Raph1821/SpiRobs/LaTeX/main.tex

\documentclass[a4paper, 11pt]{report}
\usepackage[a4paper, margin=1.5cm]{geometry}

% Police
\usepackage{lmodern}

% Interlignes et paragraphes
\usepackage{setspace} % pour l'interligne
\usepackage{parskip}  % pour gérer l'espacement entre les paragraphes

% Pour les espacements entre les titres
\usepackage{titlesec}
\titlespacing*{\subsubsection}{0pt}{0.5em}{0.3em}  % marge gauche, avant, après

% Interligne multiple de 1.15
\setstretch{1.15}

% Espace après paragraphe : 6pt
\setlength{\parskip}{6pt}
\setlength{\parindent}{0pt} % Retrait en début de paragraphe

\usepackage{titlesec}
\usepackage{etoolbox}
\usepackage{chngcntr}

% Compteur pour les chapitres personnalisés
\newcounter{chapcount}
\renewcommand{\thechapcount}{\arabic{chapcount}}

% Redéfinir \section pour l'affichage personnalisé
\titleformat{\section}
  {\centering\Large\bfseries} % Style : centré, gros, en gras
  {Chapitre \thechapcount   :}   % Numérotation personnalisée
  {0.3em}                        % Espace entre "chapitre X :" et le titre
  {}

% Incrémenter le compteur à chaque section
\preto\section{\stepcounter{chapcount}}

\usepackage[french]{babel}
\usepackage[utf8]{inputenc}
\usepackage[T1]{fontenc}

\usepackage{graphicx} % Pour les images
\graphicspath{Figures}
\usepackage{caption}
\usepackage{siunitx} % for S column in tabular
\usepackage{subcaption}
\usepackage{amsmath, amsfonts, amssymb} %Pour les maths

\usepackage{textcase}

\usepackage{afterpage}

\usepackage[symbol]{footmisc} % pour utiliser * au lieu de 1,2,3

\usepackage{float}  % pour [H]

% La numérotation

\makeatletter\@addtoreset{section}{chapter}\makeatother
\renewcommand{\thepart}{\Roman{part}}
\renewcommand{\thechapter}{\arabic{chapter}}
\renewcommand{\thesection}{\arabic{section}}
\renewcommand{\thesubsection}{\arabic{chapcount}.\alph{subsection}}
\renewcommand{\thefootnote}{\fnsymbol{footnote}}  % active les symboles pour les footnotes

\usepackage{chngcntr}
\counterwithin{figure}{section}

% Sommaire + hyperliens

\usepackage[hyphens]{url}
\usepackage[pdfauthor = {{Julien Sagnes}}, pdftitle = {{Rapport de Projet}}, pdfstartview = Fit, pdfpagelayout = SinglePage, pdfnewwindow = true, bookmarksnumbered = true, breaklinks, colorlinks, linkcolor = black, urlcolor = black, citecolor = black, linktoc = all]{hyperref}
\usepackage[
    left = \flqq{},% 
    right = \frqq{},% 
    leftsub = \flq{},% 
    rightsub = \frq{} %
]{dirtytalk} % permet de citer mieux

% Codes

\usepackage{booktabs}
\usepackage{listings}
\usepackage{xcolor}
\usepackage[section]{placeins}
\usepackage{enumitem}
\usepackage{accsupp}

\newcommand{\noncopynumber}[1]{%
    \BeginAccSupp{method=escape,ActualText={}}%
    #1%
    \EndAccSupp{}%
}

\lstdefinestyle{csvstyle}{
    basicstyle=\ttfamily\small,
    backgroundcolor=\color{gray!5},
    frame=single,
    columns=fullflexible,
    breaklines=true,
    postbreak=\mbox{\textcolor{red}{$\hookrightarrow$}\space}
}

\definecolor{codegreen}{rgb}{0,0.6,0}
\definecolor{codegray}{rgb}{0.5,0.5,0.5}
\definecolor{codepurple}{rgb}{0.58,0,0.82}
\definecolor{backcolour}{rgb}{0.95,0.95,0.92}

\lstdefinestyle{mystyle}{
    backgroundcolor=\color{backcolour},   
    commentstyle=\color{codegreen},
    keywordstyle=\color{magenta},
    numberstyle=\tiny\color{codegray},
    stringstyle=\color{codepurple},
    basicstyle=\ttfamily\footnotesize,
    breakatwhitespace=false,         
    breaklines=true,                 
    captionpos=b,                    
    keepspaces=true,                 
    numbers = left,
    numberstyle=\tiny\noncopynumber,
    numbersep=5pt,                  
    showspaces=false,                
    showstringspaces=false,
    showtabs=false,                  
    tabsize=2,
    literate=
  {á}{{\'a}}1 {é}{{\'e}}1 {í}{{\'i}}1 {ó}{{\'o}}1 {ú}{{\'u}}1
  {Á}{{\'A}}1 {É}{{\'E}}1 {Í}{{\'I}}1 {Ó}{{\'O}}1 {Ú}{{\'U}}1
  {à}{{\`a}}1 {è}{{\`e}}1 {ì}{{\`i}}1 {ò}{{\`o}}1 {ù}{{\`u}}1
  {À}{{\`A}}1 {È}{{\'E}}1 {Ì}{{\`I}}1 {Ò}{{\`O}}1 {Ù}{{\`U}}1
  {ä}{{\"a}}1 {ë}{{\"e}}1 {ï}{{\"i}}1 {ö}{{\"o}}1 {ü}{{\"u}}1
  {Ä}{{\"A}}1 {Ë}{{\"E}}1 {Ï}{{\"I}}1 {Ö}{{\"O}}1 {Ü}{{\"U}}1
  {â}{{\^a}}1 {ê}{{\^e}}1 {î}{{\^i}}1 {ô}{{\^o}}1 {û}{{\^u}}1
  {Â}{{\^A}}1 {Ê}{{\^E}}1 {Î}{{\^I}}1 {Ô}{{\^O}}1 {Û}{{\^U}}1
  {œ}{{\oe}}1 {Œ}{{\OE}}1 {æ}{{\ae}}1 {Æ}{{\AE}}1 {ß}{{\ss}}1
  {ű}{{\H{u}}}1 {Ű}{{\H{U}}}1 {ő}{{\H{o}}}1 {Ő}{{\H{O}}}1
  {ç}{{\c c}}1 {Ç}{{\c C}}1 {ø}{{\o}}1 {å}{{\r a}}1 {Å}{{\r A}}1
  {€}{{\EUR}}1 {£}{{\pounds}}1
}
\lstset{style=mystyle}

\begin{document}

\definecolor{darkWhite}{rgb}{0.94,0.94,0.94}

% Page de garde

\begin{titlepage}
    \setcounter{page}{1}
    \thispagestyle{plain}
    \newcommand{\HRule}{\rule{\linewidth}{0.5mm}}
    \begin{center}
        \begin{minipage}{1\linewidth}
            \begin{flushleft}
                \hspace{6.5cm}
                
            \end{flushleft}
        \end{minipage}

        \vspace{1.5cm}
        
        \textsc{\Large{}Master Sciences de l'ingénieur - Sorbonne Université} \\[0.5cm]
        \textsc{\large{}Année 2024 - 2025} \\[0.5cm]

        \HRule \\[0.6cm]
        {\huge\bfseries{}Rapport de projet de M1, parcours SAR :} \\
        \LARGE{Conception et réalisation d'une pince à trois doigts souples} \\[0.25cm]
        \HRule \\[1.5cm]

        \Large\textit{Auteurs :}\\
        \begin{center}
            Julien \textsc{Sagnes}\\
            Minh \textsc{Nhut Nguyen}
        \end{center}

        \hfill

        \Large\textit{Encadrant :}\\
        \begin{center}
            Faiz \textsc{Ben Amar}
        \end{center}
        \vspace{1cm}
        {\large\today} \\[2cm]
    \end{center}

    \vfill
\end{titlepage}

\setcounter{page}{2}

\selectlanguage{french}
% Résumé sur une page séparée avant la table des matières
\clearpage
\section*{Résumé}
\addcontentsline{toc}{section}{Résumé}

Ce rapport présente la conception, la modélisation et la simulation d’une pince robotique à trois doigts souples, destinée à la préhension d’objets légers comme des fruits et des légumes, et avec une capacité de charge maximale de 5 kg. S’appuyant sur les principes du robot SpiRob et des structures souples bio-inspirées, le système utilise des doigts imprimés en 3D en TPU selon une géométrie en spirale logarithmique, actionnés par un mécanisme vis-écrou couplé à des câbles. En outre, l’élasticité intrinsèque des doigts leur permet de revenir spontanément à leur position initiale lorsque les câbles sont relâchés.

Le document s’ouvre sur un état de l’art consacré aux préhenseurs souples et aux dispositifs d’actionnement par câbles, en soulignant les avantages de la compliance passive ainsi que les contraintes à relever en termes de charge et de tension des câbles. Un approfondissement est également mené sur la simulation d’élasticité par éléments finis, afin d’évaluer le comportement mécanique des structures souples. La conception de la pince est ensuite décrite de manière détaillée, depuis la définition mathématique des spirales jusqu’à la modélisation complète des pièces sous SolidWorks. Cette modélisation comprend la base, les doigts et les éléments de transmission (glissière, vis, écrou, support moteur), tout en prenant en compte les principales contraintes de conception, notamment les jeux, les frottements et l’hyperstatisme.

Enfin, une simulation par éléments finis permet d’évaluer les contraintes subies lors de la fermeture des doigts en TPU. Les résultats montrent que la pince peut saisir des objets de masse modérée sans dépasser la limite d’élasticité du matériau. Toutefois, au-delà d’une tension de 15 Newton, une plastification ou une fatigue du TPU peut survenir. L’ajout d’un élément de rappel mécanique, tel qu’un élastique, est donc recommandé afin de garantir le retour des doigts à leur position initiale.

\clearpage
\tableofcontents
\clearpage

\setcounter{chapcount}{0} % Démarre le compteur à zéro juste avant l'introduction
\section{Introduction}

    Dans l'industrie, la robotique collaborative, ou cobotique, est omniprésente. Elle vise à soulager l’être humain en prenant en charge les tâches pénibles, notamment à l’aide de préhenseurs conçus spécifiquement pour manipuler des charges de taille et de poids variable, souvent associées à des tâches répétitives.

    Ce projet consiste à concevoir et dimensionner une pince robotique à trois doigts souples, conçue pour s'ouvrir et se refermer en s'adaptant à l'objet saisi. L'objectif est de réussir à attraper des fruits et légumes relativement légers, comme un poivron. Idéalement, nous devrons pouvoir soulever des objets allant jusqu'à 5 kilogrammes. Nous utiliserons SolidWorks pour modéliser la pince, et étudierons son élasticité par éléments finis via le module \textit{SolidWorks Simulation}.

    \subsection{Motivations et principes fondamentaux}

        \begin{figure}[h]
            \centering
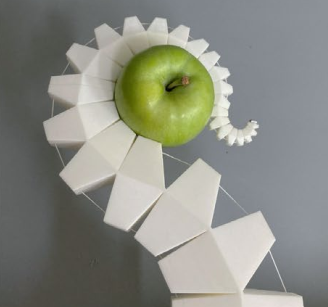
[picture p9: LaTeX/Figures/pieuvre.png]
            
            \caption{Inspiration du SpiRob pour les 3 doigts de notre pince \cite{wang_spirobs_2025}}
            \label{fig:pieuvre}
        \end{figure}
    
        Dans notre cas, et comme souvent en robotique, les objets à manipuler ont une forme ou une position mal connue, et contrairement à une main humaine, les pinces robotiques manquent de retour tactile fiable. Pour cette raison, nous n'allons pas utiliser de retour haptique, mais plutôt des préhenseurs souples. Pour concevoir nos doigts, nous nous inspirons de la flexibilité des tentacules de pieuvre et du robot SpiRob (voir figure \ref{fig:pieuvre}). Cela permettra à la pince de s'adapter naturellement à la forme de divers fruits et légumes sans nécessiter de capteurs ni de système de contrôle complexe, mais simplement grâce à la compliance mécanique. En effet, la compliance désigne la capacité d’un robot à adapter la rigidité de ses mouvements en fonction des forces extérieures qu'il subit. Autrement dit, il ajuste naturellement sa posture pour bien épouser l’objet qu’il manipule. Dans ce projet, nous nous concentrons sur la compliance passive, où la structure mécanique du robot est suffisamment flexible pour se déformer sous l'effet d'une contrainte externe. Cette approche permet une préhension polyvalente et adaptable. \cite{noauthor_gestion_2016}

        \begin{figure}[h]
            \centering
            \begin{subfigure}[t]{0.7\textwidth}
                \centering
                
                \caption{Spiral logarithmique du préhenseur \cite{wang_spirobs_2025}}
                \label{fig:spiral_logarithm}
                \end{subfigure}
            \hfill
            \begin{subfigure}[t]{0.6\textwidth}
                \centering
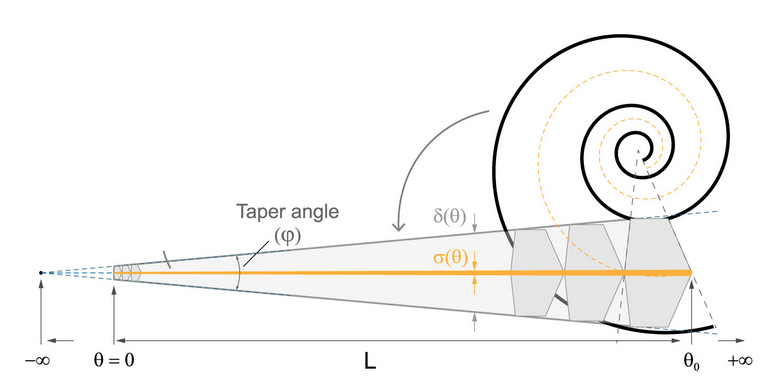
[picture p10: LaTeX/Figures/draw_solidworks.png]
                
                \caption{Construction du doigt en "dépliant" la spirale logarthimique \cite{wang_spirobs_2025}}
                \label{fig:draw_solidworks}
            \end{subfigure}
            \caption{Conception du doigt}
            \label{fig:doigt}
        \end{figure}

        Les SpiRobs dont nous nous inspirons utilisent des câbles pour provoquer les mouvements d'enroulement (curling) et de déroulement (uncurling). Une extrémité du câble est fixée à l'unité distale par un nœud de pêcheur, tandis que l'autre est reliée à un moteur (voir figure~\ref{fig:spiral_logarithm}). La contraction des câbles entraîne l'enroulement en spirale logarithmique, alors que leur relâchement, combiné à l'élasticité intrinsèque du robot, restitue la forme initiale. En effet, les SpiRobs sont entièrement fabriqués en TPU (Thermoplastic Polyurethane). Ce matériau souple, que nous utiliserons également, offre une bonne compliance mécanique et une rigidité suffisante pour transmettre efficacement la tension des câbles. La couche centrale qui relie entre elles les phalanges agit comme un ressort passif, permettant le déroulement du robot sans nécessiter d’articulations ni de moteurs multiples~\cite{wang_spirobs_2025}.

    \subsection{Comportement et structure de la pince à concevoir}
    
        La pince pourra adopter deux configurations : ouverte ou fermée. Elle est constituée de trois doigts en TPU souple, d’une hauteur de 10 cm chacun, encastrés rigidement à une base. Les doigts seront positionnés symétriquement autour du centre de la base, séparés par un angle de 120°. Ils devront être dimensionnés de manière à éviter toute plastification du TPU et garantir le comportement élastique attendu. Une étude de l’élasticité devra en conséquence être effectuée. Par ailleurs, trois câbles, passant du côté fléchisseur de chaque doigt, permettront leur actionnement grâce à un moteur chargé de régler leur tension. Dans ce type de mécanisme, la tension appliquée aux câbles constitue en effet une préoccupation majeure, car si elle est insuffisante, elle peut provoquer un relâchement des câbles et compromettre le contrôle efficace du mouvement. Du reste, pour limiter la friction des câbles, nous pouvons utiliser des câbles UHMWPE pour leur faible coefficient de frottement et leur résistance à l'usure. \cite{wang_spirobs_2025}
        
\clearpage

\section{État de l'art}

    Dans un premier temps, nous proposons un état de l'art sur les préhenseurs souples et leurs actionneurs afin d'avoir une vue globale sur leurs intérêts et les solutions existantes.

    \subsection{Préhenseurs souples}

            \begin{figure}[htbp]
                \centering
                \begin{subfigure}[t]{0.5\textwidth}
                    \centering
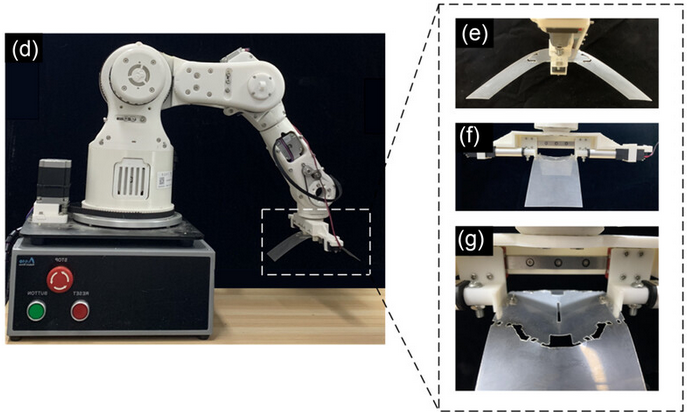
[picture p11: LaTeX/Figures/robot.png]
                    
                    \caption{Robot portant la pince souple \cite{liu_origami_2023}}
                    \label{fig:pince_PVC}
                \end{subfigure}
                \hfill
                \begin{subfigure}[t]{0.5\textwidth}
                    \centering
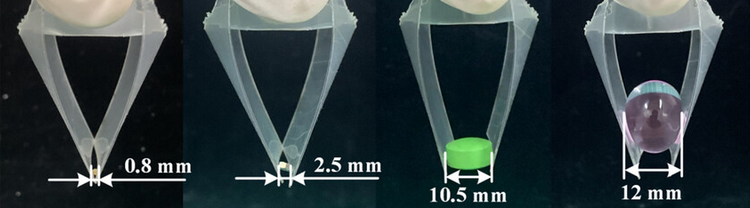
[picture p12: LaTeX/Figures/adaptability.png]
                    
                    \caption{Adaptation de la pince souple \cite{liu_origami_2023}}
                    \label{fig:prehension_adapt}
                \end{subfigure}
                \caption{Pince en PVC souple}
                \label{fig:resume_origami}
            \end{figure}

            Cette étude a été menée afin de concevoir des préhenseurs souples en origami, permettant une adaptabilité de préhension pour de nombreux objets. La pince, qui n'est qu'une simple feuille de PVC (voir figure \ref{fig:pince_PVC}), est commandée à l'aide d'un moteur linéaire. Grâce à sa structure flexible, elle peut saisir efficacement des objets de taille diverse pour le même actionnement (voir figure \ref{fig:prehension_adapt}). Cependant, sa capacité de préhension demeure limitée pour des charges dépassant 113.88 g, la force de préhension de la pince et les frottements n’étant pas suffisants pour maintenir ou saisir ces objets.

            Ces travaux mettent en évidence la grande adaptabilité des préhenseurs souples, tout en soulignant leur capacité de charge limitée. Notre pince vise à dépasser cette contrainte en améliorant la préhension grâce à la présence de trois doigts.
                
    \subsection{Actionnement par câbles}

        \subsubsection{Mécanisme \textit{level wind}}

            \begin{figure}[htbp]
                \centering

                \begin{subfigure}[t]{0.3\textwidth}
                    \centering
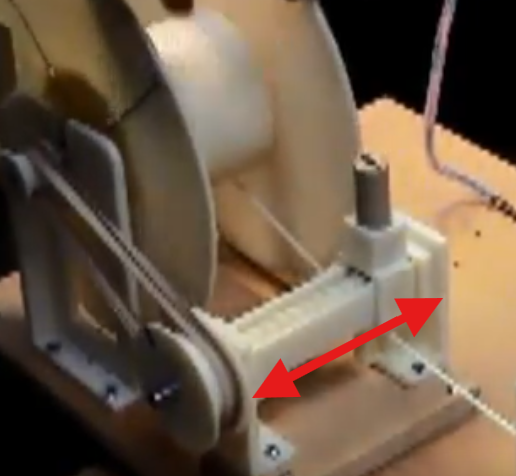
[picture p13: LaTeX/Figures/video.png]
                    
                    \caption{Illustration du mécanisme d'enroulement \cite{hugh_lyman_level_2014}}
                    \label{fig:video}
                \end{subfigure}
                \hspace{0.1\textwidth}
                \begin{subfigure}[t]{0.5\textwidth}
                    \centering
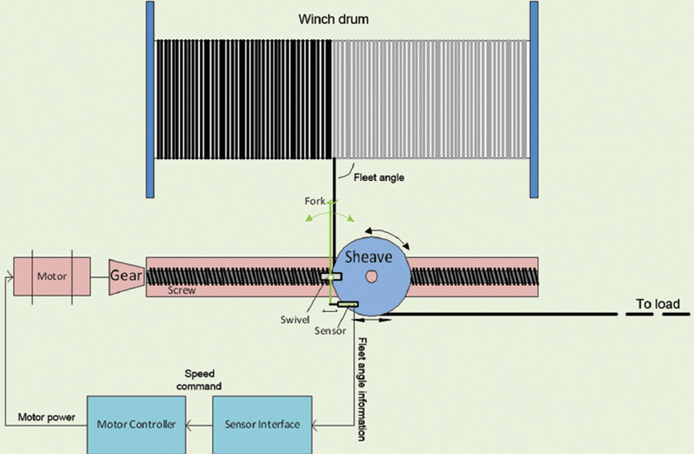
[picture p14: LaTeX/Figures/level_wind.png]
                    
                    \caption{Principe de fonctionnement du système type \textit{level wind} \cite{mortensen_precision_2014}}
                    \label{fig:level_wind}
                \end{subfigure}
                \caption{Représentation du mécanisme \textit{level wind}}
            \end{figure}

            Le mécanisme \textit{level wind} est un dispositif utilisé notamment sur les moulinets de pêche, qui guide le fil de pêche latéralement pendant l’enroulement pour éviter les enchevêtrements et maintenir une tension constante. La vidéo \cite{hugh_lyman_level_2014} illustre ce mécanisme (voir figure \ref{fig:video}).

            Sur la figure \ref{fig:level_wind}, nous proposons une illustration du système. Une poulie se déplace le long d'une vis grâce à un moteur, et enroule alors le fil tout le long du tambour. L'approche la plus répandue pour la conception d'un tel système consiste en un rapport d'engrenage fixe entre la rotation du tambour du treuil et la poulie de l'enrouleur de niveau. Un rapport fixe signifie que pour chaque tour complet du tambour, la poulie se déplace d'une distance constante. En somme, cela permet à la poulie de se déplacer horizontalement à une vitesse proportionnelle à celle de rotation du tambour.
            
            Cette solution est parfaitement envisageable pour notre pince, puisque nous resterons dans des plages de distance et de vitesse relativement faibles, limitant ainsi toute accumulation d’erreur dans la position de la poulie par rapport au tambour.

        \subsubsection{Vis à bille}

            \begin{figure}[h]
                \centering
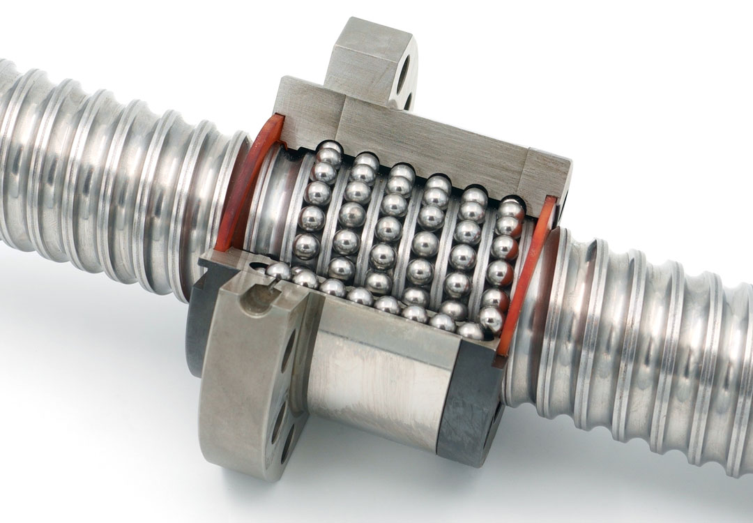
[picture p15: LaTeX/Figures/vis_à_bille.jpg]
                
                \caption{Illustration en coupe d'une vis à billes \cite{noauthor_gradel-baudin_nodate}}
                \label{fig:vis_a_billes}
            \end{figure}

            Enfin, nous nous intéressons à l’actionnement par vis à billes, un système comparable au mécanisme vis-écrou classique, et qui permettrait de tendre ou de détendre les câbles. En effet, les vis à billes sont parmi les composants les plus couramment employés pour convertir la rotation d’un moteur en mouvement linéaire. Elles présentent l’avantage de réduire considérablement les frottements, grâce au contact entre la vis et l’écrou qui s’effectue uniquement par l’intermédiaire de billes (voir figure \ref{fig:vis_a_billes}). \cite{verl_double_2014}

    \subsection{Simulation par éléments finis}
    
        En outre, nous étudions le cas d'une simulation d'un doigt robotique qui présente de nombreuses similitudes au nôtre.

        \begin{figure}[htbp]
            \centering
            \begin{subfigure}[b]{0.4\textwidth}
                \centering
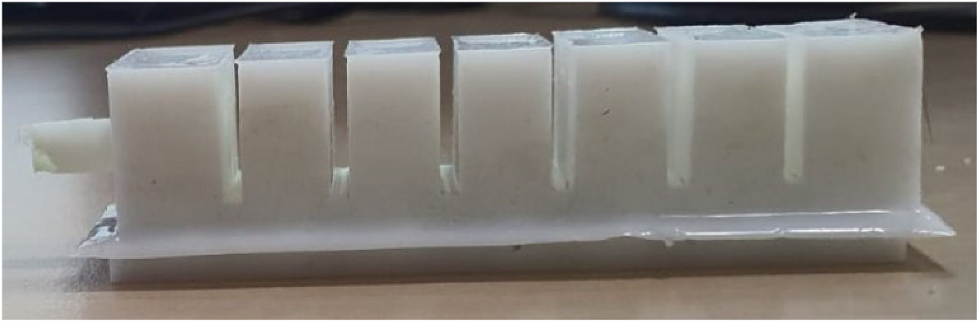
[picture p16: LaTeX/Figures/doigt_souple.jpg]
                
                \caption{Doigt souple inspiré d'un humain \cite{bhat_numerical_2025}}
                \label{fig:doigt_souple}
            \end{subfigure}
            \hspace{0.1\textwidth}
            \begin{subfigure}[b]{0.3\textwidth}
                \centering
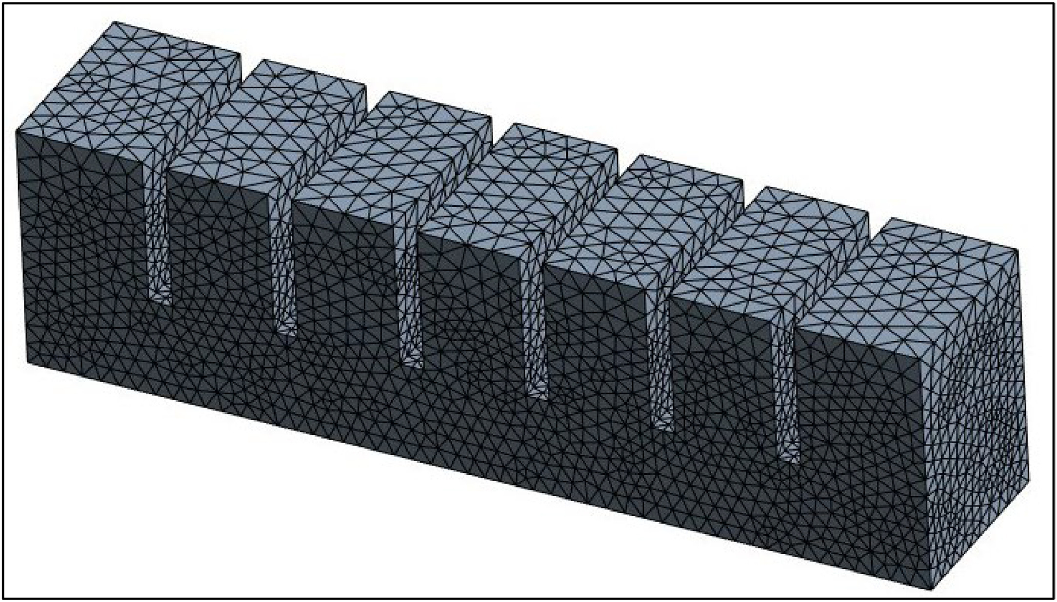
[picture p17: LaTeX/Figures/doigt_finit_elements.jpg]
                
                \caption{Représentation du maillage du doigt \cite{bhat_numerical_2025}}
                \label{fig:doigt_finit_elements}
            \end{subfigure}
            \caption{Illustrations du doigt souple et de son maillage}
            \label{fig:doigts_cote_a_cote}
        \end{figure}

        Dans \cite{bhat_numerical_2025}, les auteurs développent un actuateur souple pneumatique bio-inspiré, conçu pour la préhension douce et les applications thérapeutiques. Ce dispositif imite la flexion d’un doigt humain par l'action de la pression sur des chambres internes segmentées (voir figure \ref{fig:doigt_souple}).

        L’effecteur est réalisé en silicone liquide (LSR), un matériau hyperélastique beaucoup plus souple que notre TPU, avec un module d’Young environ dix fois inférieur. Le comportement élastique est modélisé par la loi de Yeoh d'ordre 2, et est supposé isotrope, homogène et incompressible. Le modèle est défini par la formulation faible du problème établie par l'équation d'équilibre : $div(\sigma) + \rho f = 0$, avec \( \sigma \) le tenseur des contraintes, \( \rho \) la masse volumique, et \( f \) les forces volumiques.

        L’analyse est menée via un modèle éléments finis utilisant des tétraèdres quadratiques (éléments d'ordre 2), avec un maillage raffiné (\( 63\,772 \) éléments, taille 3 mm).

        \begin{figure}[H]
            \centering
            \begin{subfigure}[b]{0.4\textwidth}
                \centering
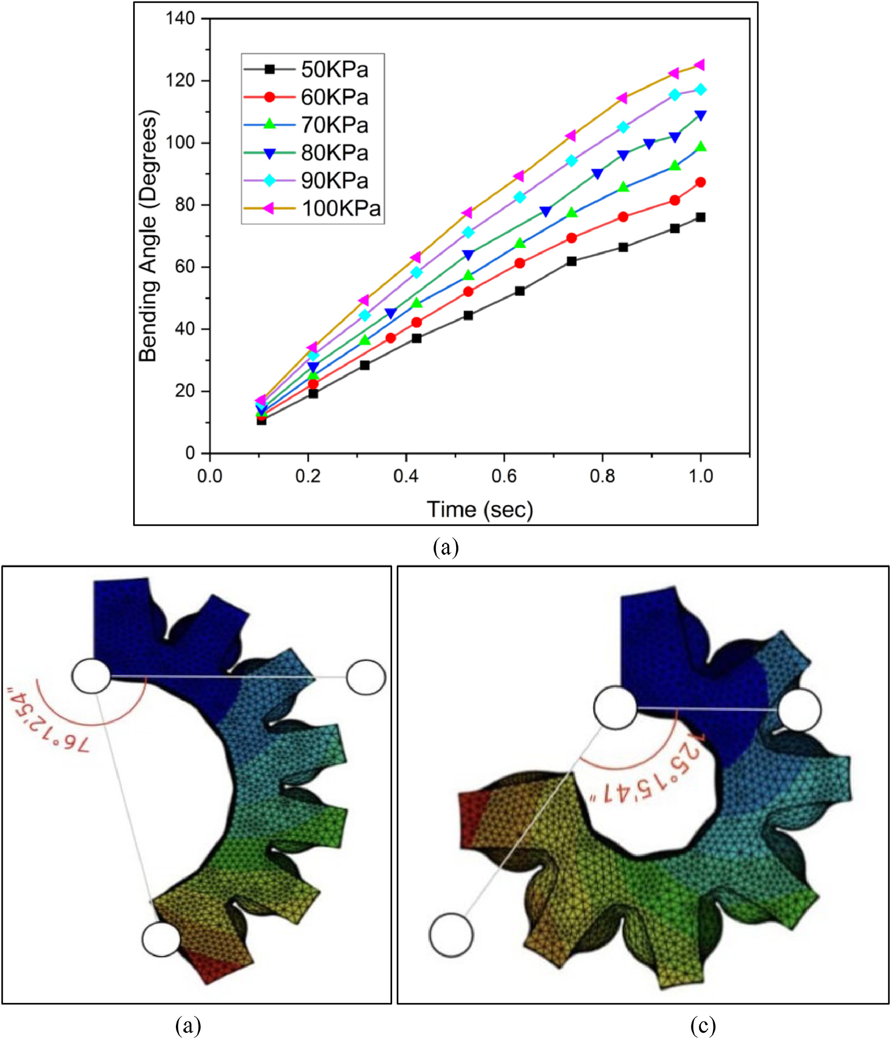
[picture p18: LaTeX/Figures/angle_pression.jpg]
                
                \caption{Angle parcouru suivant la pression exercée (en haut), et effecteur pour une pression de 50 kPa et 100 kPa.}
                \label{fig:angle_pression}
            \end{subfigure}
            \hspace{0.1\textwidth}
            \begin{subfigure}[b]{0.4\textwidth}
                \centering
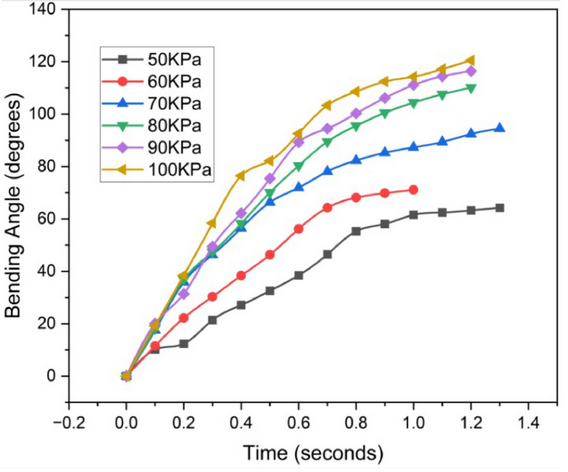
[picture p19: LaTeX/Figures/angle_pression_experiments.png]
                
                \caption{Angle parcouru suivant la pression exercée lors de l'expérience.}
                \label{fig:angle_pression_experiments}
            \end{subfigure}
            \caption{Comparaison entre les résultats numériques et expérimentaux \cite{bhat_numerical_2025}.}
            \label{fig:angle_pression_comparaison}
        \end{figure}

        La simulation indique que l’actionneur produit une force de préhension comprise entre 2 et 2,71 N pour des pressions allant de 50 à 100 kPa (voir figure \ref{fig:angle_pression}). En revanche, les résultats expérimentaux montrent une relation moins linéaire (voir figure \ref{fig:angle_pression_experiments}) et une force maximale plus élevée, atteignant 5 N à 100 kPa, alors que la simulation ne prévoit que 2,71 N. Cette différence s’explique par un débit d’air prolongé lors des tests expérimentaux, ce qui permet à l’actionneur de se gonfler davantage et donc de générer une force plus importante.

        Ces travaux mettent en évidence que les résultats obtenus par simulation par éléments finis peuvent s’écarter significativement des observations expérimentales. Bien que notre approche par câbles soit différente, cet article nous a été utile pour explorer un modèle de déformation et réaliser une simulation à l’aide d’un logiciel de CAO.

\clearpage
        
\section{Conception de la pince}
        
    \subsection{Considérations mathématiques}

        Dans \cite{wang_spirobs_2025}, les auteurs expliquent comment dessiner le SpiRob. Comme dit précédemment, nous nous inspirons de sa forme pour concevoir nos doigts.

        \subsubsection{Spirale centrale}
            
            Sur la figure \ref{fig:spiral_logarithm}, la spirale centrale (notée $r_c(\theta)$, en orange) qui définit notre robot vérifie la relation :
            \begin{equation}
            r_c(\theta) = \frac{r(\theta) + r(\theta + 2\pi)}{2}, \quad \forall \theta
            \label{eq:spirale_centrale}
            \end{equation}
            
            Cela signifie qu’on prend le rayon de la spirale qui enveloppe le robot (notée $r(\theta)$, en noir) au point $\theta$ ($r(\theta)$), et au point $\theta + 2\pi$ ($r(\theta + 2\pi)$), et on calcule leur moyenne. Cela donne un point « central » pour chaque angle $\theta$, et en les reliant, on forme la spirale centrale. \cite{wang_spirobs_2025}

        \subsubsection{Coefficients de la spirale centrale}
        
            La spirale logarithmique centrale en coordonnées polaires est de la forme :

            \begin{equation}
                r_c(\theta) = a_c e^{b_c \theta}, \quad \text{avec} \quad a_c > 0
                \label{eq:spirale_log}
            \end{equation}

            Afin que la première phalange ne soit pas trop petite, la spirale centrale sera bornée par $\theta \in [\pi, \theta_0 + \pi]$, avec $\theta_0$ le nombre de tours de la spirale. De plus, $a_c$ est un paramètre d’échelle (elle détermine la taille globale de la spirale), tandis que $b_c$ est un coefficient qui détermine à quel point la spirale s’enroule (plus $b_c$ est grand, plus la spirale est "serrée"). Contrairement à \cite{wang_spirobs_2025}, nous n'aurons pas besoin qu'un doigt s'enroule plusieurs fois autour de l'objet pour le saisir étant donné que nous concevons ici une pince à trois doigts. Ainsi, la spirale centrale parcourra au plus 1 seul tour ($\theta_0 = 2\pi$), et $a_c$ et $b_c$ seront choisis de telle sorte qu'on obtienne la longueur désirée $L$ du doigt, soit $10$ cm.

            Pour déterminer la valeur de \( a_c \) en fonction de $b_c$ afin de satisfaire la condition sur $L$, nous procédons comme suit :

            La longueur totale \( L \) de la spirale centrale est donnée par l'intégrale de l'arc de \( \pi \) à \( 3\pi \) :
            \[
            L = \int_\pi^{\theta_0 +\pi} \sqrt{r_c^2 + \left(\frac{dr_c}{d\theta}\right)^2} \, d\theta, \quad \text{pour} \ \theta_0 = 2\pi \left( = 1 \text{ tour complet} \right)
            \]
            
            Substituons dans la racine carrée : $\sqrt{r_c^2 + \left( \frac{dr_c}{d\theta} \right)^2} = \sqrt{a_c^2 e^{2b_c \theta} (1 + b_c^2)} = a_c e^{b_c \theta} \sqrt{1 + b_c^2}$
            
            La longueur totale devient : $L = \int_\pi^{3\pi} a_c e^{b_c \theta} \sqrt{1 + b_c^2} \, d\theta = a_c \sqrt{1 + b_c^2} \int_\pi^{3\pi} e^{b_c \theta} \, d\theta$
            
            Calculons l'intégrale : $\int_\pi^{3\pi} e^{b_c \theta} \, d\theta = \left[ \frac{1}{b_c} e^{b_c \theta} \right]_\pi^{3\pi} = \frac{1}{b_c} \left( e^{b_c \cdot 3\pi} - e^{b_c \cdot \pi} \right)$
            
            Ainsi, la longueur totale de la spirale centrale est : $L = a_c \sqrt{1 + b_c^2} \cdot \frac{1}{b_c} \left( e^{b_c \cdot 3\pi} - e^{b_c \cdot \pi} \right)$
            
            En isolant \( a_c \) :

            \begin{equation}
            a_c(b_c) = \frac{L b_c}{\sqrt{1 + b_c^2} \left( e^{b_c \cdot 3\pi} - e^{b_c \cdot \pi} \right)}, \qquad \text{avec L connue}
            \label{eq:a}
            \end{equation}

        \subsubsection{Spirale déroulée}

            Etant donné l'équation (\ref{eq:a}), il ne reste qu'à déterminer la valeur optimale de $b_c$ pour définir l'équation de notre doigt. Nous la calculerons en fonction d'un angle de conicité $\phi$ désiré (\textit{taper angle} sur la figure \ref{fig:draw_solidworks}) :

            \begin{equation}
            \phi(b_c) = 2\arctan \left(
                \frac{\frac{1}{2}\delta(\theta)}{L(-\infty, \theta)}
                \right) = 2 \arctan\left(\frac{b_c(e^{2\pi b_c}-1)}{\sqrt{b_c^2+1} \left(e^{2\pi b_c}+1\right)}\right)
            \label{eq:angle_de_conicite}
            \end{equation}

            Avec :

            \begin{itemize}
                \item l'épaisseur du robot à l'angle $\theta$ : $\delta(\theta) = a_ce^{b_c(\theta + 2\pi)} - a_ce^{b_c\theta}$
                \item la longueur du robot entre $[-\infty,\theta]$ : $L(-\infty, \theta) = \int_{-\infty}^{\theta} \sqrt{r_c^2 + \left(\frac{dr_c}{d\theta}\right)^2} \, d\theta$.
            \end{itemize}

            Le fait que $\phi$ soit indépendant de $\theta$ signifie que la forme est effilée \cite{wang_spirobs_2025}.

        \subsubsection{Nombre de phalanges}
            
            Enfin, nous devrons choisir l'espacement $\Delta\theta$ entre les phalanges de la figure \ref{fig:spiral_logarithm} pour définir entièrement la forme et la taille du doigt. On peut alors en déduire le nombre de phalanges N puisque $\theta_0 = 2\pi$ :
        
            \begin{equation}
                N = \frac{\text{Angle total}}{\Delta \theta}
                = \frac{\theta_0}{\Delta \theta}
                = \frac{2\pi}{\Delta \theta}
                \label{eq:nb_segment}
            \end{equation}

    \subsection{Cahier des charges retenu} 

            \begin{itemize}
                \item Angle de conicité (ou \textit{taper angle}) : $\phi \ = \ 15^o \ = \ \frac{\pi}{12} \ rad$ 
                \item Angle entre 2 phalanges adjacentes : $\Delta \theta \ = \ 30^o \ = \ \frac{\pi}{6} \ rad$
                \item Couche élastique qui relient les phalanges : 10 $\%$ de la largeur du doigt
            \end{itemize}

            \subsubsection{Discussion sur le cahier des charges à respecter}

            L'angle de conicité de la spirale joue un rôle clé dans les performances de préhension du doigt, notamment en termes d’espace de travail, de précision de saisie et de capacité de charge. 
            D’après les résultats rapportés dans \cite{wang_spirobs_2025}, un faible angle de conicité permet d’augmenter significativement l’espace de travail, en élargissant la zone accessible par les doigts lors du déploiement. À l’inverse, un angle de conicité plus élevé améliore la performance de saisie : il permet de saisir des objets de plus petite taille (diamètre minimal réduit) tout en augmentant la capacité de charge maximale du robot.
            Par exemple, un SpiRob avec un angle de conicité de $15^\circ$ peut saisir des objets dont le diamètre varie de 5{,}6\,mm à 115\,mm, et supporter une charge allant jusqu’à 10\,kg, soit environ 260 fois son propre poids (poids du robot : 38{,}4\,g). \cite{wang_spirobs_2025} Notre but étant de manipuler des fruits et légumes de diamètres allant jusqu'à 10 cm, nous avons choisi d’adopter un angle de conicité de $\phi = 15^\circ$.

            Concernant la discrétisation angulaire $\Delta \theta$ (espacement des phalanges), une valeur trop élevée limite la capacité du robot à s’enrouler en une spirale logarithmique fluide, ainsi nous choisissons un $\Delta \theta$ de 30° pour garantir une déformation satisfaisante. Il convient également d’éviter une couche élastique trop épaisse (au centre du doigt robotique), car cela augmenterait la force nécessaire pour enrouler le doigt, rendant l'actionnement par câbles plus exigeant pour le moteur qui utiliserait alors davantage d'énergie. Nous adoptons les recommandations de \cite{wang_spirobs_2025}, en optant pour une épaisseur de couche élastique de 10\,\%, assurant un bon compromis entre élasticité et force d’enroulement.

        \subsubsection{Détermination des paramètres pour répondre au cahier des charges}

            Pour satisfaire les exigences du cahier des charges ci-dessus, nous cherchons les valeurs des paramètres $N$, $a_c$ et $b_c$ qui y répondent : 

            Comme montré dans l’équation (\ref{eq:nb_segment}), le nombre de phalanges dépend de l’angle total $\theta_0$ et l'espacement $\Delta \theta$, on peut donc déduire le nombre de phalanges comme suit :

            \[
                N = \frac{2\pi}{\Delta \theta}
                = \frac{2\pi}{\frac{\pi}{6}}
                = 12 
            \]
            
            Il y aura donc 12 phalanges.

            Ensuite, nous devons déterminer $b_c$ de telle sorte que $\phi = \frac{\pi}{12}$.
            
            Nous le calculons grâce à l'équation (\ref{eq:angle_de_conicite}) en appliquant la méthode \texttt{fsolve} de \texttt{Python}:

            \begin{lstlisting}[language=Python,caption={Résolution numérique du paramètre $b$},label={lst:resolu_b},xleftmargin=0pt]

            # Résolution de l'équation pour b
            def equation(b):
                if b == 0:
                    return -taper_angle_rad  # éviter division par 0
                numerator = b * (np.exp(2 * np.pi * b) - 1)
                denominator = np.sqrt(b**2 + 1) * (np.exp(2 * np.pi * b) + 1)
                angle = 2 * np.arctan(numerator / denominator)
                return angle - taper_angle_rad

            # Valeur initiale proche (tester avec 0.05, 0.1, etc.)
            b_solution = fsolve(equation, x0=0.01 , xtol = 1e-6)[0]
            if b_solution <= 0:
                raise ValueError("La solution pour b doit être positive.")
            b=b_solution
            \end{lstlisting}

            La fonction \texttt{equation} renvoie la différence :
            \[
            \texttt{equation}(b) = \phi(b) - \texttt{taper\_angle\_rad}, \qquad \text{pour} \texttt{ taper\_angle\_rad} = \frac{\pi}{12}
            \]

            Ainsi, la résolution de \( \texttt{equation}(b_c) = 0 \) correspond à trouver la racine de cette fonction, c'est-à-dire la valeur de \( b \) pour laquelle \(\phi(b)\) est égale à \(\texttt{taper\_angle\_rad}\).

            \textbf{Signification de \texttt{x0} et \texttt{xtol} dans \texttt{fsolve}} :
            \begin{itemize}
                \item \(\mathbf{x0}\) : C'est la \textit{valeur initiale} ou \textit{point de départ} donné à l'algorithme numérique pour commencer la recherche de la racine. Comme la résolution numérique dépend du point de départ, choisir un \( x_0 \) proche de la racine attendue facilite la convergence et évite d'obtenir des solutions erronées.

                \item \(\mathbf{xtol}\) : C'est la \textit{tolérance sur la solution} que l'on fixe pour arrêter la recherche de la racine. Plus précisément, lorsque la variation de \( x \) (la valeur approchée de la racine) entre deux itérations est inférieure à \(\texttt{xtol}\), l'algorithme considère que la solution est suffisamment précise et s'arrête.
            \end{itemize}

            \textbf{Nous avons donc reçu la valeur de $b_c\ =\ 0.2230302381847426$, et avons déduit $a_c\ =\ 3.530268404263818$ avec l'équation (\ref{eq:a})}.

        Ainsi, afin que notre doigt réponde au cahier des charges, il faut que la spirale centrale d'équation (\ref{eq:spirale_log}) soit définie par :

        \[
        r_c = a_c e^{b_c\theta}, \qquad \text{avec } b_c = 0.2230, \text{ } a_c = 3.5303
        \]

        Nous cherchons maintenant l'équation de la spirale qui enveloppe le doigt, soit $r(\theta) = f(r_c(\theta))$. Pour cela, on peut
        déduire la formule inverse de (\ref{eq:spirale_centrale}) en posant $r(\theta) = ae^{b\theta}$ :

        $$r_c(\theta) = \frac{r(\theta) + r(\theta + 2\pi)}{2}, \quad \forall \theta$$

        $$r_c(\theta) = \frac{ae^{b\theta} + ae^{b(\theta + 2\pi)}}{2}
        = \frac{ae^{b\theta}}{2}(1 + e^{2\pi b})
        = \frac{r(\theta)}{2}(1 + e^{2\pi b})$$

        \begin{equation}
            \implies r(\theta) = \frac{2 \cdot r_c(\theta)}{1 + e^{2\pi b}}
            \label{eq:spirale_centrale_inverse}
        \end{equation}

        Nous avons l'équation des deux spirales ; nous pouvons passer au dessin du doigt.

    \subsection{Dessin sur SolidWorks}

        \subsubsection{Dessin du doigt}
            
            Nous allons expliquer comment dessiner le doigt à l'aide des outils de SolidWorks. La méthode consiste à dessiner le doigt dans sa forme enroulée, puis à enregistrer chaque phalange individuellement. Ainsi, nous nous assurons qu'il s'enroulera correctement.

            \begin{figure}[H]
                \centering
                \begin{subfigure}[t]{0.3\textwidth}
                    \centering
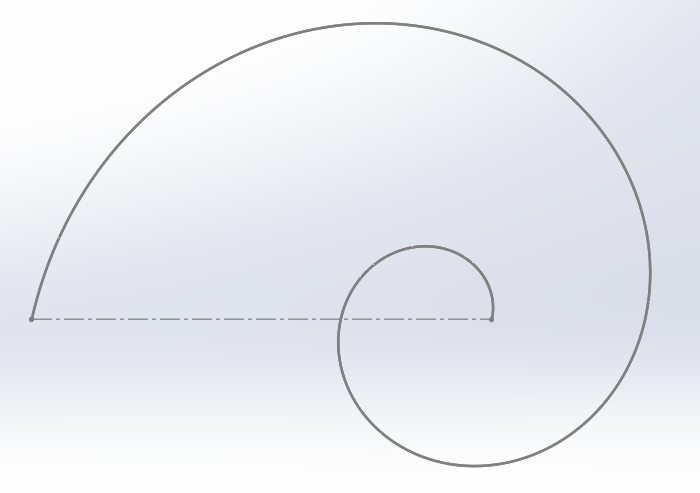
[picture p20: LaTeX/Figures/esquisse_spirale_1.png]
                    
                    \caption{Esquisse de la spirale centrale, d'équation \ensuremath{r_c = a_ce^{b_c \theta}} avec \ensuremath{\theta \in [0,3\pi]}}
                \end{subfigure}
                \hspace{0.1\textwidth}
                \begin{subfigure}[t]{0.3\textwidth}
                    \centering
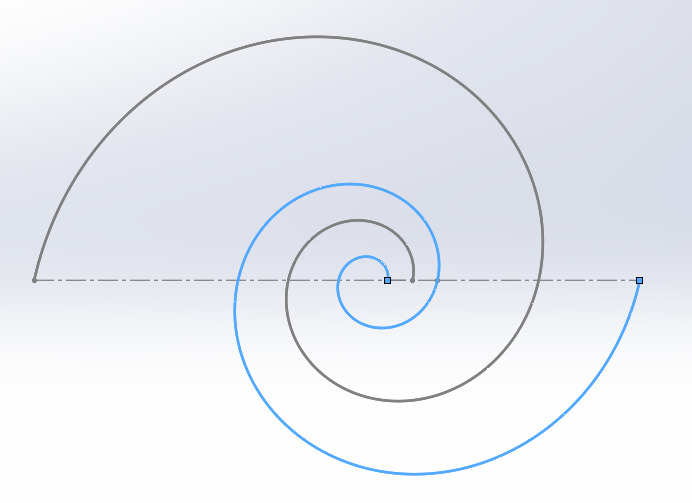
[picture p21: LaTeX/Figures/esquisse_spirale_2.png]
                    
                    \caption{Esquisse de la spirale qui enveloppe le doigt (en bleue), d'équation \ensuremath{r = \frac{2 \cdot r_c(\theta)}{1 + e^{2\pi b}}} avec \ensuremath{\theta \in [0,4\pi]}}
                \end{subfigure}
                \caption{Dessin des spirales élémentaires du doigt}
                \label{fig:esquisse_spirale}
            \end{figure}

            La figure \ref{fig:esquisse_spirale} présente les esquisses des deux spirales. Elles ont été tracées à l’aide d’une méthode paramétrique. Ces courbes permettent de valider nos calculs, puisque la spirale centrale reste bien centrée pour tout $\theta$.

            \begin{figure}[H]
                \centering
                \begin{subfigure}[t]{0.4\textwidth}
                    \centering
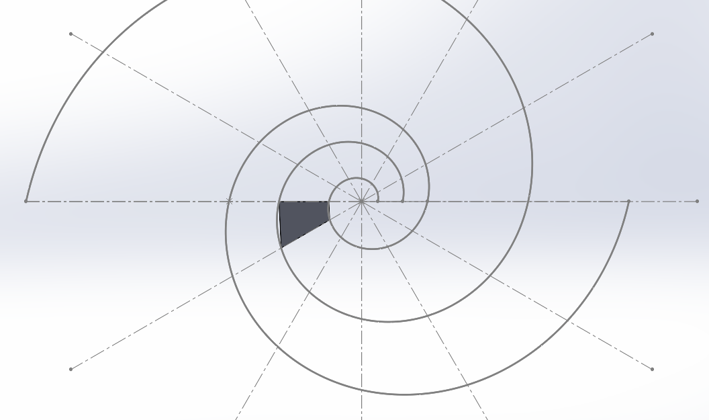
[picture p22: LaTeX/Figures/esquisse_moitié_trapèze_1.png]
                    
                    \caption{Esquisse de l'étoile pour discrétiser la spirale, et extrusion de la moitié de la première phalange à l'aide des lignes construites}
                \end{subfigure}
                \hspace{0.1\textwidth}
                \begin{subfigure}[t]{0.4\textwidth}
                    \centering
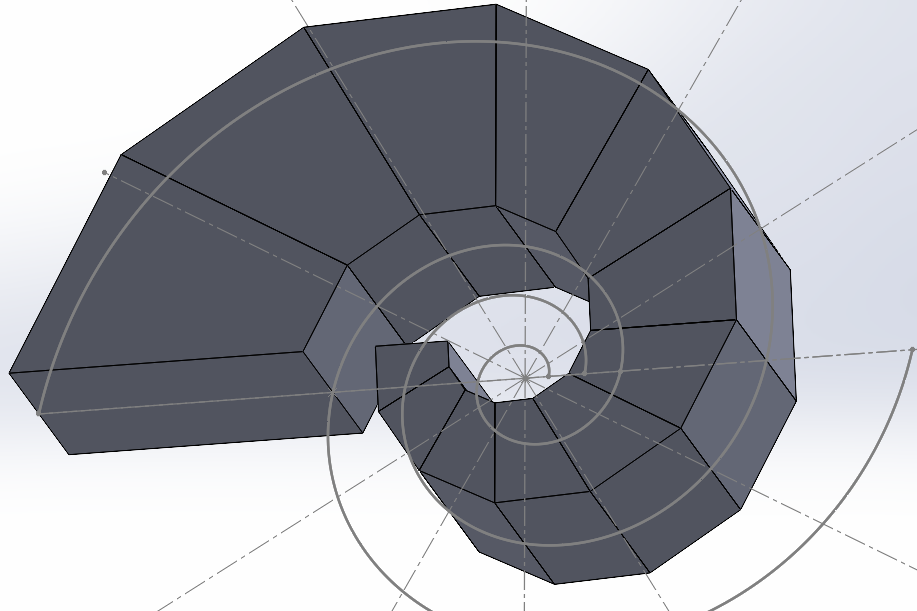
[picture p23: LaTeX/Figures/esquisse_moitié_trapèze_entier.png]
                    
                    \caption{Extrusion de toutes les moitiés des phalanges à l'aide des lignes construites}
                \end{subfigure}
                \caption{Dessin de l'étoile et des phalanges}
                \label{fig:esquisse_etoile}
            \end{figure}

            Comme illustré sur la figure \ref{fig:esquisse_etoile}, nous dessinons l'étoile dont le centre est l'origine du repère polaire utilisée pour tracer les spirales. Comme en $\theta = 0$, on a $r_c(0) = a_c e^0 = a_c$, alors l'origine de l'étoile se trouve à une distance $a_c$ du point de départ de la spirale centrale. Ensuite, nous dessinons chacune des moitiés de phalanges en prenant soin de ne pas fusionner les extrusions.

            \begin{figure}[H]
                \centering
                \begin{subfigure}[t]{0.4\textwidth}
                    \centering
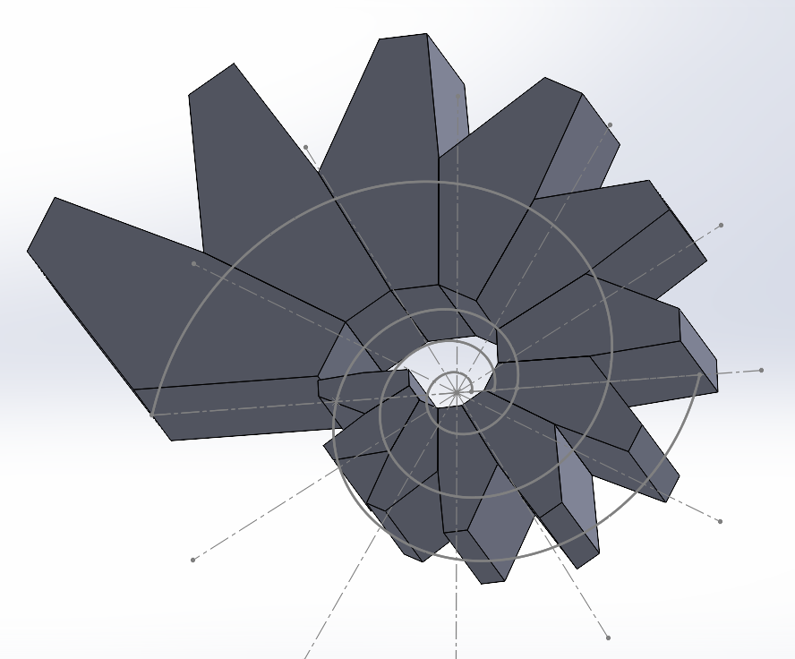
[picture p24: LaTeX/Figures/esquisse_trapèze_symetrie.png]
                    
                    \caption{Symétrie de toutes les phalanges}
                    \label{fig:symetrie_phalanges}
                \end{subfigure}
                \hspace{0.1\textwidth}
                \begin{subfigure}[t]{0.4\textwidth}
                    \centering
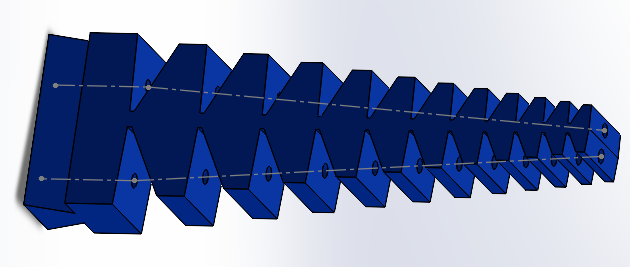
[picture p25: LaTeX/Figures/doigt.png]
                    
                    \caption{Doigt assemblé et perçage des trous sur les côtés pour faire passer le câble}
                    \label{fig:doigt_assemble}
                \end{subfigure}
                \caption{Dessin et assemblage du doigt}
                \label{fig:spirale_enroule}
            \end{figure}

            Enfin, nous rendons symétriques les moitiés de phalanges et les sauvegardons dans des fichiers de pièces distincts (voir figure \ref{fig:symetrie_phalanges}). Cela permet ensuite de les assembler de manière à obtenir un doigt déroulé. De plus, nous intégrons une couche élastique représentant 10\% de la largeur du doigt pour connecter les phalanges entre elles. Bien que chaque doigt soit actionné par un unique câble côté fléchisseur, nous prévoyons des trous de part et d’autre pour garantir la symétrie de la pièce (voir figure \ref{fig:doigt_assemble}).
            
            \subsubsection{Dessin de la base}

            \begin{figure}[H]
                \centering
                \begin{subfigure}[t]{0.5\textwidth}
                    \centering
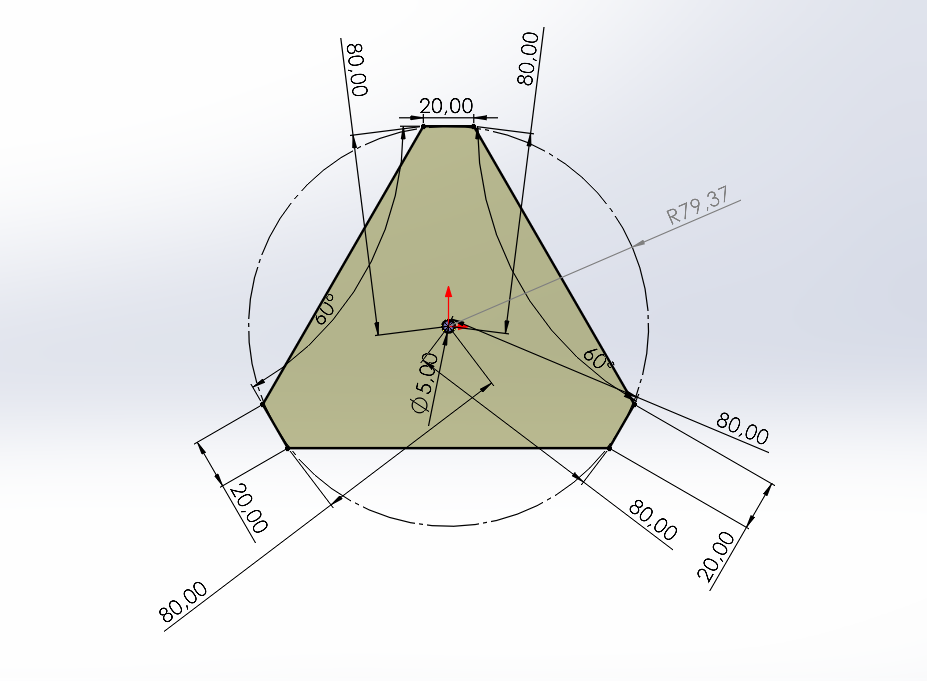
[picture p26: LaTeX/Figures/base_circonscrit.png]
                    
                    \caption{Esquisse de la base de rayon 80 mm}
                \end{subfigure}
                \hfill
                \begin{subfigure}[t]{0.4\textwidth}
                    \centering
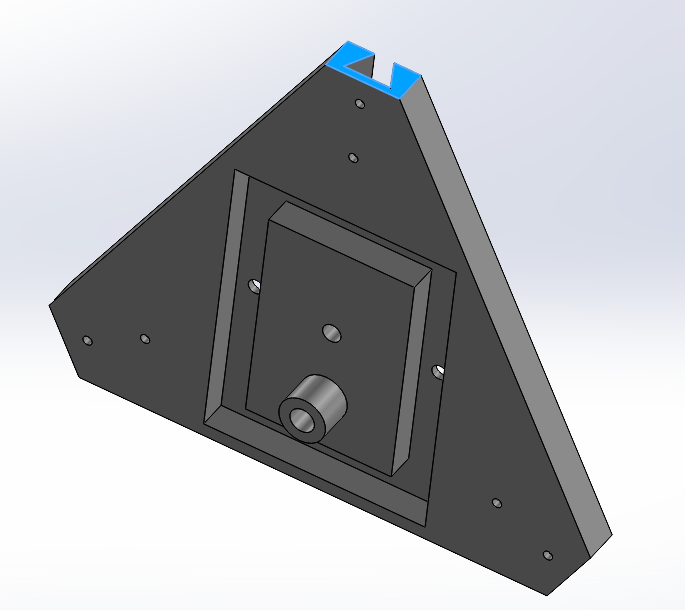
[picture p27: LaTeX/Figures/base_hareng.png]
                    
                    \caption{Illustration de la queue de hareng pour accueillir le doigt, ainsi que de la cavité pour loger le support moteur}
                \end{subfigure}
                \caption{Conception de la base}
                \label{fig:base}
            \end{figure}

            Nous concevons une base de forme triangulaire, dont le cercle circonscrit présente un rayon d’environ 80 mm, afin de pouvoir manipuler des fruits de taille conséquente. Le doigt est encastré à la base grâce à un système d’accroche en queue de hareng, avec un jeu de 0,3 mm prévu pour permettre l’assemblage (par la suite, nous adopterons toujours ce jeu pour chaque pièce). Ce même jeu est appliqué à la cavité destinée à accueillir le support moteur qui sera accroché à la base (voir figure \ref{fig:base}).
            
            \begin{figure}[H]
                \centering
                \begin{subfigure}[t]{0.3\textwidth}
                    \centering
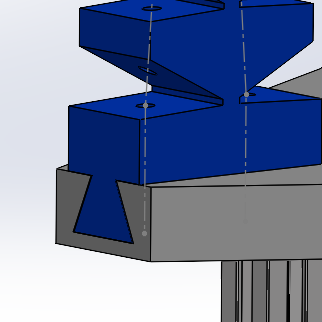
[picture p28: LaTeX/Figures/encastrement_doigt_base.png]
                    
                    \caption{Encastrement du doigt dans la base avec un jeu de 0.3 mm}
                \end{subfigure}
                \hspace{0.1\textwidth}
                \begin{subfigure}[t]{0.2\textwidth}
                    \centering
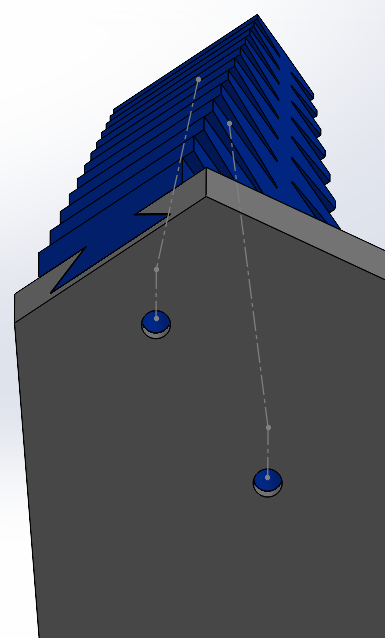
[picture p29: LaTeX/Figures/trou_base_cable.png]
                    
                    \caption{Trous dans la base pour faire passer les câbles dans les doigts}
                \end{subfigure}
                \caption{Conception de la base}
                \label{fig:base_doigt}
            \end{figure}
            
            En outre, nous n'oublions pas de creuser des trous dans la base afin de pouvoir faire passer les câbles dans les doigts (voir figure \ref{fig:base_doigt}).

        \subsubsection{Dessin du support du moteur}

            \begin{figure}[H]
                \centering
                \begin{subfigure}[t]{0.35\textwidth}
                    \centering
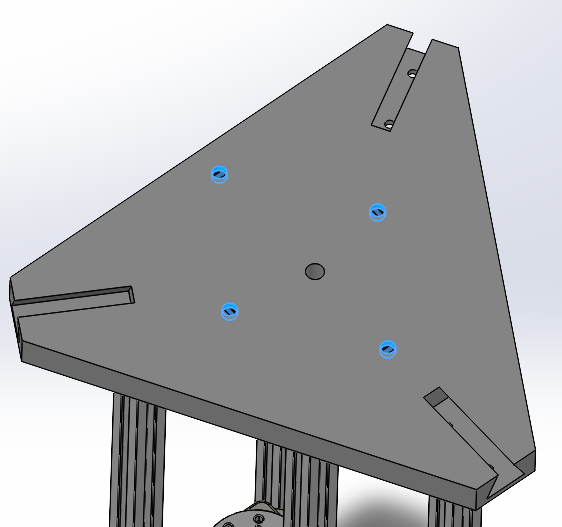
[picture p30: LaTeX/Figures/support_fixation.png]
                    
                    \caption{4 trous de diamètre 4,3 mm percés dans la base pour fixer les 4 barres (en bleu)}
                    \label{fig:fixation_base_support}
                \end{subfigure}
                \hspace{0.1\textwidth}
                \begin{subfigure}[t]{0.2\textwidth}
                    \centering
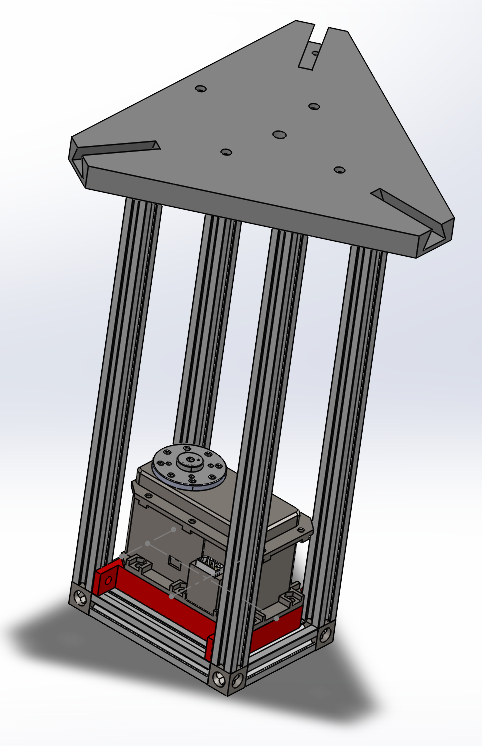
[picture p31: LaTeX/Figures/support_idee.png]
                    
                    \caption{Support moteur en MAKERBEAM, avec la pièce pour y fixer le moteur (en rouge)}
                    \label{fig:support}
                \end{subfigure}
                \caption{Conception du support}
            \end{figure}

            Le support moteur est conçu à l’aide de la bibliothèque MAKERBEAM (voir figure \ref{fig:support}). Il est assemblé à partir de barres de 40 mm, 60 mm et 200 mm, ainsi que de cubes de jonction. La fixation du support à la base est assurée par des vis à tête marteau et des boulons. Cela nécessite la réalisation de quatre perçages de 4,3 mm de diamètre dans la base, centrés sur chaque barre (voir figure \ref{fig:fixation_base_support}).

            Le servomoteur MX-106 de chez Dynamixel a été retenu pour ce montage, car il permet un contrôle précis en position et en vitesse grâce au PID intégré et offre le couple le plus élevé parmi les moteurs que nous avions à disposition (10 Nm).

            Une pièce supplémentaire est conçue pour maintenir le moteur. Elle présente des perçages en bordure permettant d'y accrocher le moteur à l'aide de vis. Les trous situés sur les extensions latérales servent à fixer la pièce sur les barres MAKERBEAM (voir figure \ref{fig:support}).

        \subsubsection{Dessin du système vis-écrou}

            \begin{figure}[H]
                \centering
                \begin{subfigure}[t]{0.5\textwidth}
                    \centering
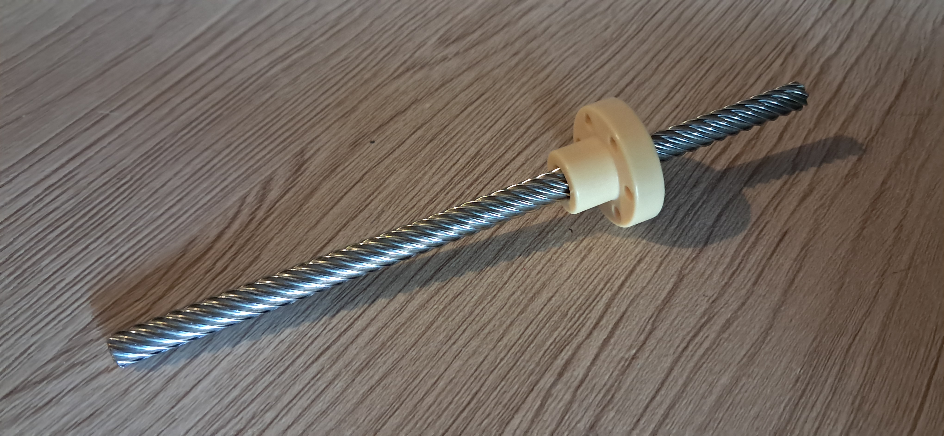
[picture p32: LaTeX/Figures/vis_sans_fin.jpg]
                    
                    \caption{Notre vis mère de la marque Igus en acier trempé, permettant un très faible frottement}
                \end{subfigure}
                \hspace{0.1\textwidth}
                \begin{subfigure}[t]{0.2\textwidth}
                    \centering
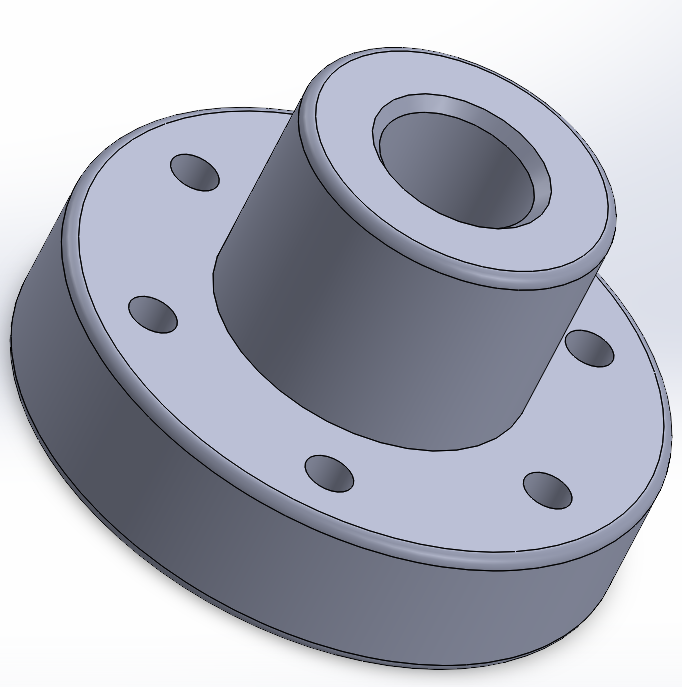
[picture p33: LaTeX/Figures/ecrou_trou.png]
                    
                    \caption{Modèle de l'écrou dessiné sur SolidWorks pour permettre l'assemblage CAO}
                \end{subfigure}
                \caption{Illustrations de la vis mère et de l'écrou}
                \label{fig:vis_sans_fin}
            \end{figure}

            Après discussion avec notre encadrant, nous avons décidé de ne pas utiliser de tambour pour l'actionnement par câbles. Bien que le tambour soit une solution efficace, l'actionnement des câbles préalablement prétendus par un système vis-écrou s’avère plus simple à mettre en œuvre et se révèle moins encombrant. À la place d'une vis à billes, nous optons pour une vis mère Igus en acier trempé afin de réduire les frottements, accompagnée d'un écrou (voir figure \ref{fig:vis_sans_fin}). Selon les recommandations du fabricant \cite{noauthor_bague_nodate}, l’écrou doit impérativement être protégé contre les efforts de torsion et les déplacements axiaux excessifs. Nous veillerons donc à intégrer des dispositifs de guidage alignés et parallèles afin d’assurer la stabilité et la durabilité du mécanisme.

            \begin{figure}[H]
                \centering
                \begin{subfigure}[t]{0.25\textwidth}
                    \centering
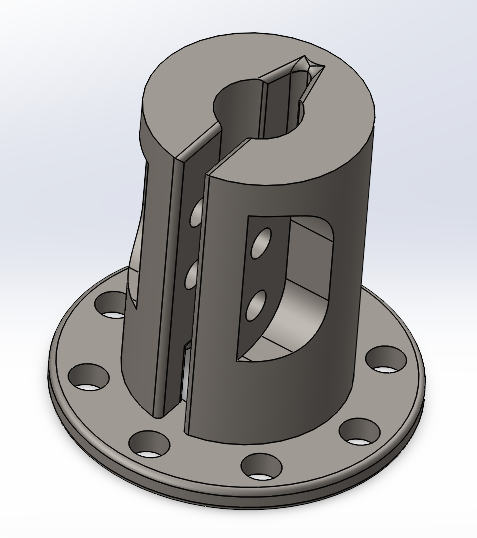
[picture p34: LaTeX/Figures/piece_manquante.png]
                    
                    \caption{Dispositif de serrage entre la vis et le moteur, pour transmettre le couple}
                    \label{fig:piece_manquante}
                \end{subfigure}
                \hspace{0.1\textwidth}
                \begin{subfigure}[t]{0.30\textwidth}
                    \centering
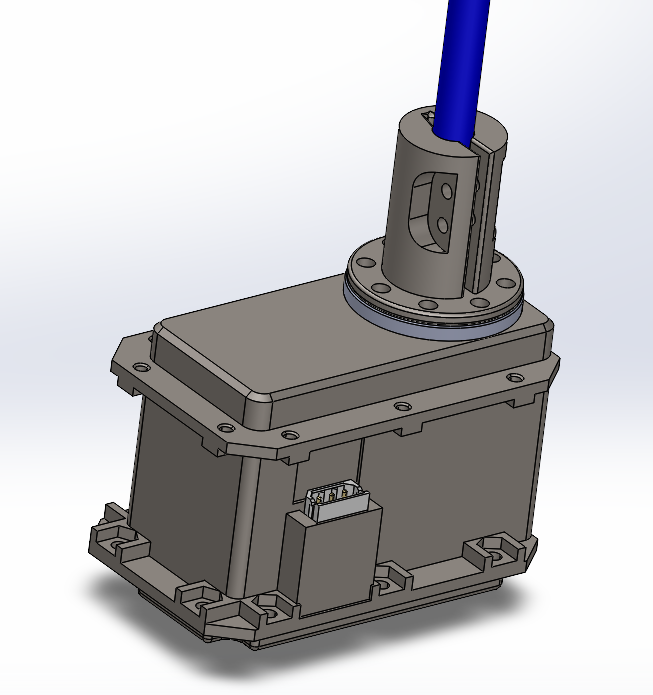
[picture p35: LaTeX/Figures/attache.png]
                    
                    \caption{Accouplement entre la vis mère (en bleue) et le moteur par le biais du dispositif de serrage}
                    \label{vis_serree}
                \end{subfigure}
                \caption{Accouplement de transimission de couple}
            \end{figure}

            Comme illustré à la figure \ref{fig:piece_manquante}, nous concevons une pièce spécifique destinée à transmettre le couple moteur à la vis mère. Inspirée d’une bague de serrage, cette pièce de transmission intègre huit perçages permettant de la fixer solidement au moteur à l’aide de vis de 2 mm de diamètre. Par ailleurs, deux vis-écrou assurent le serrage de la vis mère dans l’alésage prévu à cet effet, garantissant ainsi une bonne adhérence et une transmission efficace du mouvement (voir figure \ref{vis_serree}).

            \begin{figure}[H]
                \centering
                \begin{subfigure}[t]{0.45\textwidth}
                    \centering
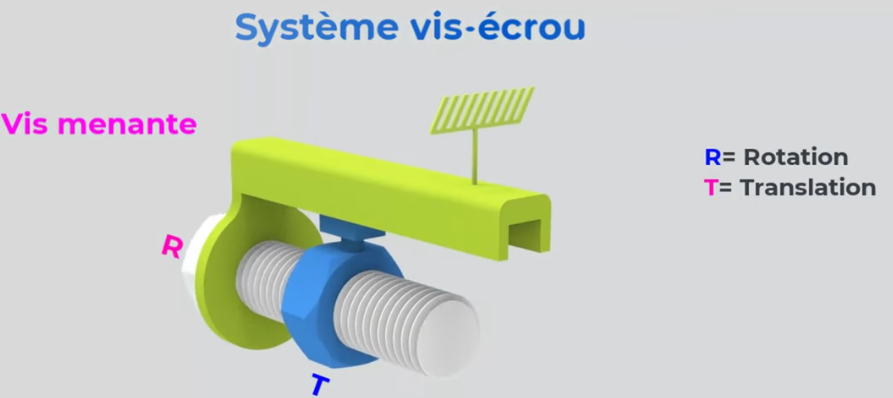
[picture p36: LaTeX/Figures/système vis écrou.png]
                    
                    \caption{Inspiration pour notre système vis écrou \cite{w3d_tech_systeme_2023}}
                    \label{fig:inspiration}
                \end{subfigure}
                \hspace{0.1\textwidth}
                \begin{subfigure}[t]{0.4\textwidth}
                    \centering
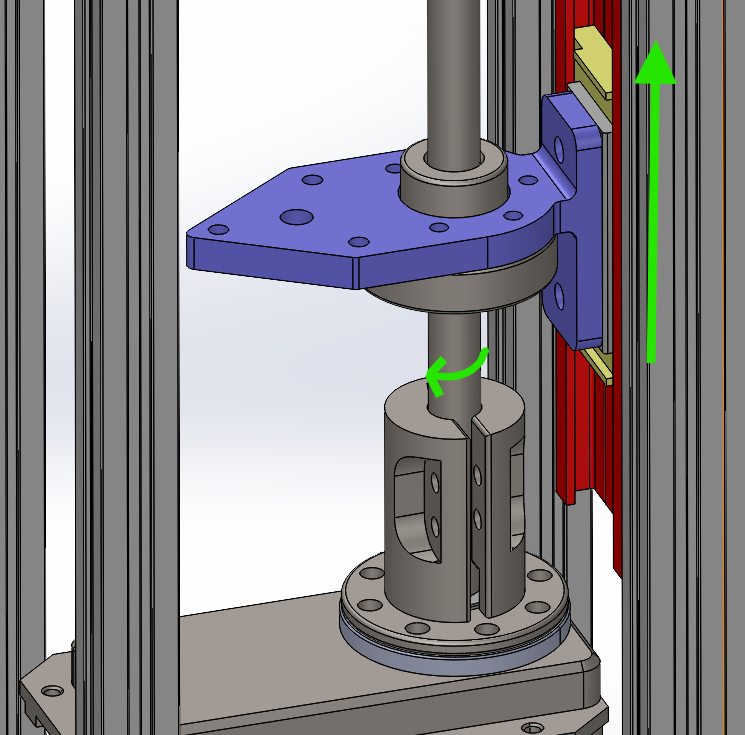
[picture p37: LaTeX/Figures/vis_ecrou_assemble.png]
                    
                    \caption{Notre système vis-écrou avec la glissière accrochée au support}
                    \label{fig:glissiere_support}
                \end{subfigure}
                \caption{Conception du système vis-écrou}
                \label{fig:attache_glissiere}
            \end{figure}

            Nous devons également associer le système vis-écrou à une glissière pour assurer le guidage linéaire. Nous avons retenu à cet effet une glissière Igus, modèle NK-01-27, accompagnée de son chariot. Il convient donc de la fixer sur le support réalisé avec la bibliothèque MAKERBEAM. Pour cela, nous utilisons une pièce de cette bibliothèque qui permet de solidariser au support la nouvelle barre destinée à recevoir la glissière.

            Du reste, la conception du système vis-écrou s’inspire de la vidéo \cite{w3d_tech_systeme_2023}. Sur la figure \ref{fig:inspiration}, le rail supérieur en vert maintient l’écrou en rotation bloquée, ce qui lui permet de translater lorsqu’un moteur fait tourner la vis. Par ailleurs, ce système empêche l’emmêlement des câbles : l’écrou reste fixe en rotation et ne fait que translater.

            Nous devons ainsi concevoir une pièce intermédiaire destinée à relier la glissière à l’écrou (en bleu sur la figure \ref{fig:glissiere_support}). Pour garantir l’hyperstatisme de l’assemblage, un minimum de trois vis est nécessaire pour fixer cette pièce à l'écrou. Nous en profitons également pour intégrer à l’extrémité de la pièce un triangle comportant trois trous aux sommets, destinés à y nouer les câbles des doigts. Étant positionné au centre du support, ce triangle présente une distance égale aux trois doigts, assurant ainsi une course identique pour chacun des câbles. En d’autres termes, l’actionnement des doigts sera ainsi uniforme.

        \subsubsection{Pince assemblée}

            \begin{figure}[H]
                \centering
                \begin{subfigure}[t]{0.40\textwidth}
                    \centering
                    
                    \caption{Pince assemblée sur SolidWorks}
                    \label{fig:pince_CAO}
                \end{subfigure}
                \hspace{0.1\textwidth}
                \begin{subfigure}[t]{0.35\textwidth}
                    \centering
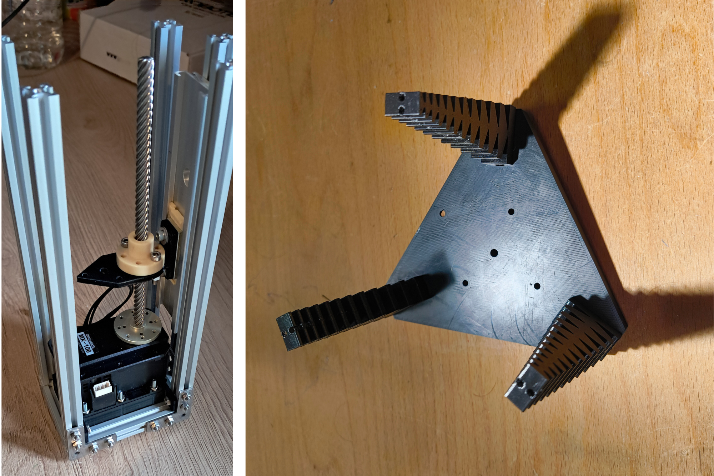
[picture p38: LaTeX/Figures/reel.png]
                    
                    \caption{Pièces imprimées et montage du support en MAKERBEAM}
                    \label{fig:reel}
                \end{subfigure}
                \caption{Conception du système vis-écrou}
                \label{fig:pince_assemble}
            \end{figure}

            Sur la figure \ref{fig:pince_assemble}, nous proposons une illustration de l'assemblage CAO finale de notre pince, ainsi que des photos de la réalisation. La sphère verte sur la base permet de simuler une pomme de diamètre 8 cm.

\clearpage

\section{Résultats}

    \subsection{Simulation et étude de l'élasticité via \textit{SolidWorks Simulation}}

        \subsubsection{Création des matériaux dans SolidWorks}

            \textit{TPU}

                Pour simuler les contraintes et les déplacements dans SolidWorks, il est nécessaire d'intégrer les propriétés mécaniques du TPU que nous utiliserons pour les doigts. Dans \cite{rodriguez-parada_influence_2021}, les auteurs utilisent un TPU de module d'Young 26 MPa. Étant donné notre objectif d’éviter tout comportement plastique, nous privilégions un matériau présentant un module d’Young relativement faible. Ainsi, pour obtenir une première estimation des efforts maximaux, et par conséquent du couple moteur à ne pas dépasser, nous retenons une valeur volontairement majorée de 30 MPa pour le module d’Young dans la simulation (sachant que plus il est élevé, moins le matériau est souple étant donnée la loi de Hooke $\sigma = E \epsilon$). Enfin, comme critère de vérification, nous adoptons comme limite d’élasticité celle du eTPU-95a utilisé dans \cite{wang_spirobs_2025}, soit $\sigma_{limite} = 8,6$ MPa.
            
            \textit{PLA}

                Pour les autres pièces imprimées, nous privilégions l'utilisation de PLA, dont le module d'Young est d’environ 3 GPa, afin de garantir une rigidité suffisante face aux efforts transmis par les câbles. Cela permet de s’assurer que les déformations se produisent comme prévu au niveau des doigts, et non sur la base.

        \subsubsection{Méthode}

            De même que dans le cadre de l'étude \cite{bhat_numerical_2025}, nous restons dans l'hypothèse des matériaux homogènes, isotropes et incompressibles. Nous décidons également de négliger la gravité. En effet, d'après SolidWorks, notre doigt mesure $25$ grammes. Son poids est donc d'environ $0,25$ N, or les forces des câbles seront de l'ordre de l'unité, voire de la dizaine de Newton puisque l'on souhaite attraper des objets allant jusqu'à 5 kilogrammes ($50$ Newton). Ainsi, la gravité représente moins de $1$ \% des efforts subis par le doigt.

            \begin{figure}[H]
                \centering
                \begin{subfigure}[t]{0.3\textwidth}
                    \centering
                    
                    \caption{Condition limite d'encastrement sur la base}
                    \label{fig:encastrement}
                \end{subfigure}
                \hspace{0.1\textwidth}
                \begin{subfigure}[t]{0.3\textwidth}
                    \centering
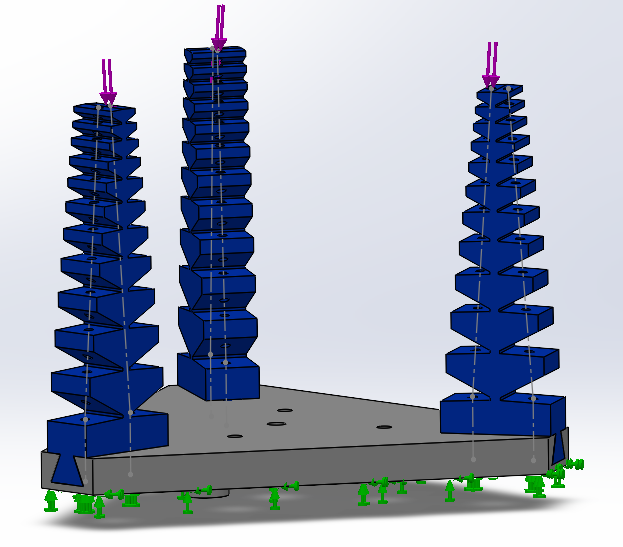
[picture p39: LaTeX/Figures/force_3_doigts.png]
                    
                    \caption{Simulation des forces (en violet) engendrées par les câbles sur l'extrémité des doigts}
                    \label{fig:force}
                \end{subfigure}
                \caption{Mise en place d'un problème bien posé}
            \end{figure}

            Dans le logiciel, nous commencons par créer une nouvelle étude statique. L’onglet \textit{Déplacements imposés} permet de définir les conditions limites, notamment en fixant la géométrie, c'est-à-dire ajouter un encastrement sur la base (voir figure \ref{fig:encastrement}, cela revient à négliger les déformations de la base dont le module d'Young est 100 fois plus élevé que celui des doigts). Ensuite, l’onglet \textit{Chargements externes} sert à appliquer les forces. Pour simuler la tension des câbles subie par les doigts, nous ajoutons une force à l'extrémité des pièces dans la direction du trou qui accueille le câble (voir figure \ref{fig:force}).

            \begin{figure}[H]
                \centering
                \begin{subfigure}[t]{0.3\textwidth}
                    \centering
                    
                    \caption{Création du maillage}
                    \label{fig:maillage}
                \end{subfigure}
                \hspace{0.1\textwidth}
                \begin{subfigure}[t]{0.4\textwidth}
                    \centering
                    
                    \caption{Simulation des contraintes}
                    \label{fig:simulation}
                \end{subfigure}
                \caption{Exécution de la simulation par éléments finis}
                \label{fig:simulation4}
            \end{figure}

        \subsubsection{Résultats}
            
            Nous générons un maillage de \(2,7 \times 10^{5}\) éléments basé sur la courbure, avant d'exécuter la simulation avec des forces de 4~N appliquées sur chacun des 3 doigts pour modéliser la prise uniforme d’un objet d’environ \(0,4 \times 3 = 1,2\) kg. Il est important de bien différencier la tension des câbles, qui correspond ici à la force de 4 N exercée sur les doigts, et la force de préhension réelle. En effet, la force de frottement qui retient l’objet est forcément plus faible que la tension exercée par les câbles : la charge effective pourrait ainsi être divisée par deux, soit environ 0,6 kg. Le logiciel va ensuite calculer les déformations et les déplacements, ainsi que les contraintes équivalentes de Von-Mises. On peut remarquer dans ce cas que la limite d'élasticité n'est pas dépassée (voir figure~\ref{fig:simulation4}) :

            \[
            2{,}346\ \text{MPa} < 8{,}6\ \text{MPa} \quad \Rightarrow \quad \sigma_{\text{max}} < \sigma_{\text{limite}}
            \]

            Ainsi, la pince peut facilement soulever des fruits ou légumes de quelques centaines de grammes sans déformation permanente, comme une pomme ou un poivron pesant en moyenne entre 150 et 200 grammes.

            \begin{figure}[h]
            \centering
            \begin{subfigure}[b]{0.5\textwidth}
                \centering
                
                \caption{Analyse des contraintes maximales pour différentes valeurs de forces}
                \label{fig:etude_de_conception_a}
            \end{subfigure}
            \hfill
            \begin{subfigure}[b]{0.4\textwidth}
                \centering
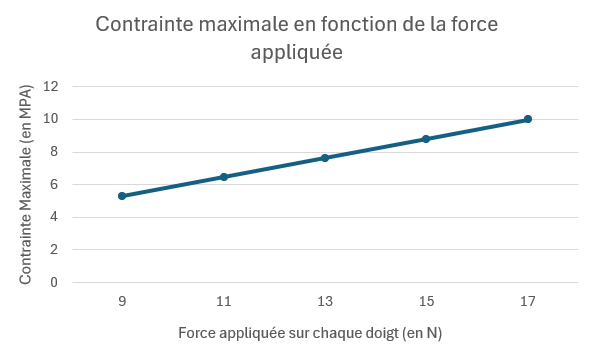
[picture p40: LaTeX/Figures/linear.png]
                
                \caption{Évolution linéaire mise en évidence}
                \label{fig:etude_de_conception_b}
            \end{subfigure}
            \caption{Analyse des contraintes maximales et mise en évidence de l’évolution linéaire, traduisant le fait que l'on reste globalement dans le domaine élastique}
            \label{fig:etude_de_conception}
        \end{figure}

            Pour réaliser plusieurs simulations, nous utilisons l’option \textit{étude de conception}. Une variable représentant la tension appliquée aux câbles y est introduite, variant de 9 N à 17 N, pour simuler le poids des objets soulevés mesurant jusqu'à $(1.7 \times 3) / 2 = 2.55$ kg. La figure \ref{fig:etude_de_conception} montre un dépassement de la limite d’élasticité pour des charges lourdes (au-delà de 2.25 kg, correspondant à une tension des câbles de plus de 15 N), et la pièce rentre ainsi dans le domaine plastique. Pour remédier à cela, nous proposons d’ajouter un élastique dans le trou extérieur inutilisé du doigt. Ce dispositif permettra à la pièce de retrouver sa position initiale grâce à l’effet de rappel de l’élastique, dans le cas où le matériau fatigue ou se plastifie.

\clearpage

\section{Synthèse et conclusion}

        Ce projet avait pour objectif de concevoir et dimensionner une pince robotique à trois doigts souples, inspirée des principes de la robotique bio-inspirée et destinée à la préhension d’objets légers jusqu’à 5 kg. Après un état de l’art des préhenseurs souples et des mécanismes d’actionnement par câbles, la conception s’est appuyée sur une modélisation mathématique des spirales logarithmiques définissant la géométrie des doigts, combinée à une modélisation 3D sous SolidWorks.

        L’assemblage complet comprend les doigts en TPU, une base, un système vis-écrou actionné par un servomoteur, ainsi qu’un support pour accrocher l'actionneur. La simulation par éléments finis a permis de vérifier le comportement élastique des doigts sous diverses charges. Les résultats montrent que la pince peut saisir efficacement des objets de masse modérée sans dépasser la limite d’élasticité du matériau, tout en mettant en évidence la nécessité éventuelle d’un dispositif de rappel par élastique pour prévenir les déformations permanentes en cas de charges élevées.

        Ce projet nous a permis de maîtriser le logiciel SolidWorks, ainsi que son module de simulation par éléments finis, \textit{SolidWorks Simulation}. Il nous a offert une expérience approfondie dans la conception d’un assemblage en tenant compte de contraintes telles que les jeux pour permettre l’assemblage, la gestion de l’hyperstatisme, le choix des vis et des outils de conception adaptés. De plus, il nous a permis d’explorer la robotique souple, d’en détailler les avantages, notamment l’adaptabilité aux formes irrégulières, et les limites, comme la faible capacité de charge. Enfin, ce projet nous a offert l’opportunité de concevoir un système d’actionnement par câbles, tout en renforçant notre compréhension des mécanismes de transmission de couple.

        Le projet a conduit à concevoir la pince au stade virtuel, avec l’ensemble des fichiers SolidWorks de chaque pièce ainsi que le code pour actionner le moteur. La phase de réalisation physique a été entamée, mais des difficultés liées à des problèmes d’impression 3D n’ont pas encore permis de finaliser l’assemblage. Une phase de prototypage et d’essais expérimentaux pourra compléter cette première étape afin de valider les performances en conditions réelles.

\bibliographystyle{IEEEtran}
\bibliography{references}
\addcontentsline{toc}{section}{Bibliographie}

\end{document}
