Raph1821/SpiRobs/Solidworks/PINCE_SIMULATION-Statique 1/PINCE_SIMULATION-Statique 1-BenchMark-Solver.txt

Solver 0.003 Linear-static-solver-Start 0 0 0 0 0 0 0 0 0 0 0 0 0 0 0 0 0 0 0 0 0 0 0 0 0 0 0 0
Solver 0.004 Loading-and-preparing-input-data-Start 0 0 0 0 0 0 0 0 0 0 0 0 0 0 0 0 0 0 0 0 0 0 0 0 0 0 0 0
Solver 0.828 Loading-and-preparing-input-data-End 0 0 0 0 0 0 0 0 0 0 0 0 0 0 0 0 0 0 0 0 0 0 0 0 0 0 0 0
Solver 0.828 Computing-load-vector-Start 0 0 0 0 0 0 0 0 0 0 0 0 0 0 0 0 0 0 0 0 0 0 0 0 0 0 0 0
Solver 0.959 Computing-load-vector-End 0 0 0 0 0 0 0 0 0 0 0 0 0 0 0 0 0 0 0 0 0 0 0 0 0 0 0 0
Solver 2.880 FFEPlus-Solver-start 0 0 0 0 0 0 0 0 0 0 0 0 0 0 0 0 0 0 0 0 0 0 0 0 0 0 0 0
Solver 2.967 Element-connectivity-Start (all) 0 0 0 0 0 0 0 0 0 0 0 0 0 0 0 0 0 0 0 0 0 0 0 0 0 0 0 0
Solver 3.024 Element-connectivity-End (all) 0 0 0 0 0 0 0 0 0 0 0 0 0 0 0 0 0 0 0 0 0 0 0 0 0 0 0 0
Solver 5.580 Element-stiffness-Start (excluding CASI Tetra10) 0 0 0 0 0 0 0 0 0 0 0 0 0 0 0 0 0 0 0 0 0 0 0 0 0 0 0 0
Solver 6.227 Element-stiffness-End (excluding CASI Tetra10) 0 0 0 0 0 0 0 0 0 0 0 0 0 0 0 0 0 0 0 0 0 0 0 0 0 0 0 0
Solver 6.265 PCGLSS-Assembly-End 0 0 0 0 0 0 0 0 0 0 0 0 0 0 0 0 0 0 0 0 0 0 0 0 0 0 0 0
Solver 7.607 PCGLSS-Preconditioner-End 0 0 0 0 0 0 0 0 0 0 0 0 0 0 0 0 0 0 0 0 0 0 0 0 0 0 0 0
Solver 10.756 FFEPlus-Solver-End 0 0 0 0 0 0 0 0 0 0 0 0 0 0 0 0 0 0 0 0 0 0 0 0 0 0 0 0
Solver 12.932 Computing-reaction-forces-for-load-case(LCASE)=1-Start 0 0 0 0 0 0 0 0 0 0 0 0 0 0 0 0 0 0 0 0 0 0 0 0 0 0 0 0
Solver 14.628 Computing-reaction-forces-for-load-case(LCASE)=1-End 0 0 0 0 0 0 0 0 0 0 0 0 0 0 0 0 0 0 0 0 0 0 0 0 0 0 0 0
Solver 14.628 Computing-stresses-for-load-case=1-Start 0 0 0 0 0 0 0 0 0 0 0 0 0 0 0 0 0 0 0 0 0 0 0 0 0 0 0 0
Solver 14.954 Computing-stresses-for-load-case=1-End 0 0 0 0 0 0 0 0 0 0 0 0 0 0 0 0 0 0 0 0 0 0 0 0 0 0 0 0
Solver 15.053 Linear-static-solver-End 0 0 0 0 0 0 0 0 0 0 0 0 0 0 0 0 0 0 0 0 0 0 0 0 0 0 0 0
SOLVER TYPE= FFEPlus (PCG Iterative Solver)
Number of Equations (NEQ)=217512
Number of Nodal points (NUMNP)=74080
Number of Pseudo nodes (NUMPS)=0
Number of Elements (NUME)=42754
Number of Pseudo Elements (NUMP)=13380
SOLVER TYPE ACTUALLY USED= FFEPlus (PCG Iterative Solver)
SOLUTION TIME LOG
Time for Input Data Transfer from Database =2.981000
TIME FOR CALCULATION OF STRUCTURE STIFFNESS MATRIX (STF_PHASE)=0.657000
TIME FOR FFEPlus (PCG ITERATIVE SOLVER) =7.240000
TIME FOR GAP & CONTACT ITERATIONS (CNT_PHASE)=0.000000
TIME FOR REACTION FORCE & DISP UPDATE TO POST (REC_PAHS)=3.856000
TIME FOR STRESS CALCULATION (STS_PHASE)=0.326000
TIME FOR WRITING POST PROCESSING INFORMATION (PST_PHASE)=0.003000
TOTAL SOLUTION TIME (TOT_TIME)=15.082000
