Raph1821/SpiRobs/LaTeX/Figures/SORBONNE_FAC_SCIENCES_DEF_CMJN.pdf

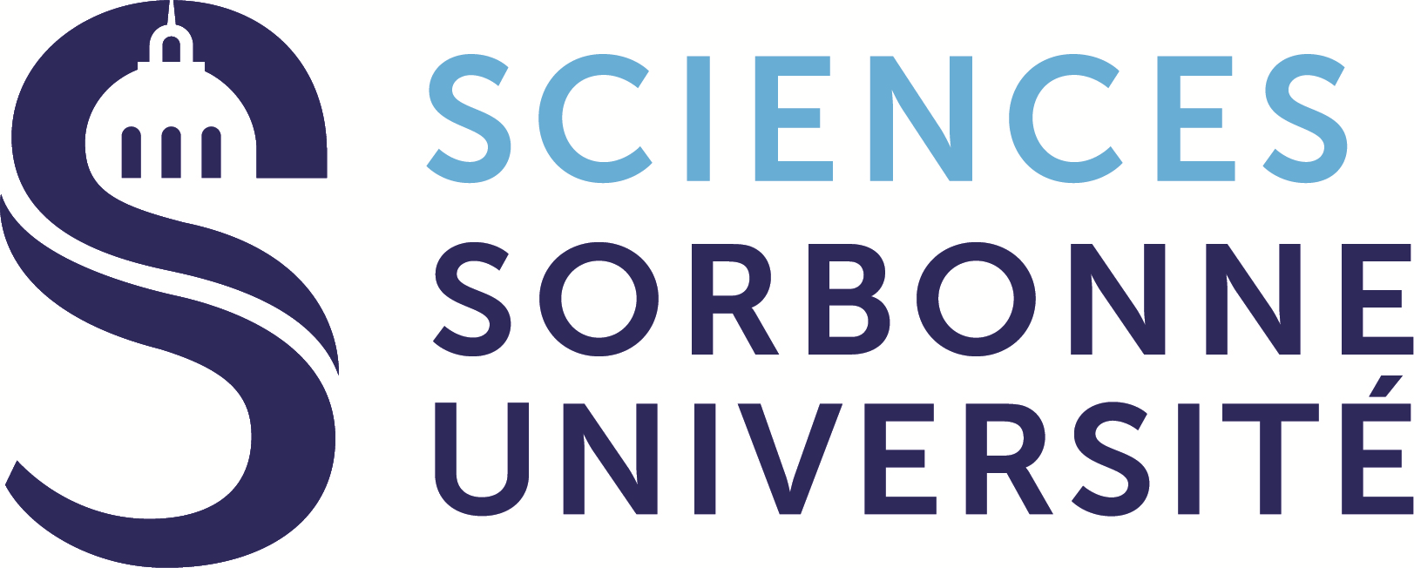
[picture p60: page 1]
