Raph1821/SpiRobs/LaTeX/Figures/accroche_glissiere.png

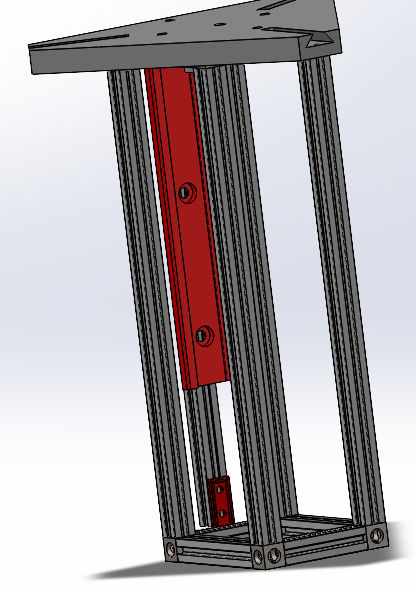
LaTeX/Figures/accroche_glissiere.png
