Raph1821/SpiRobs/LaTeX/Figures/attache_glissière.png

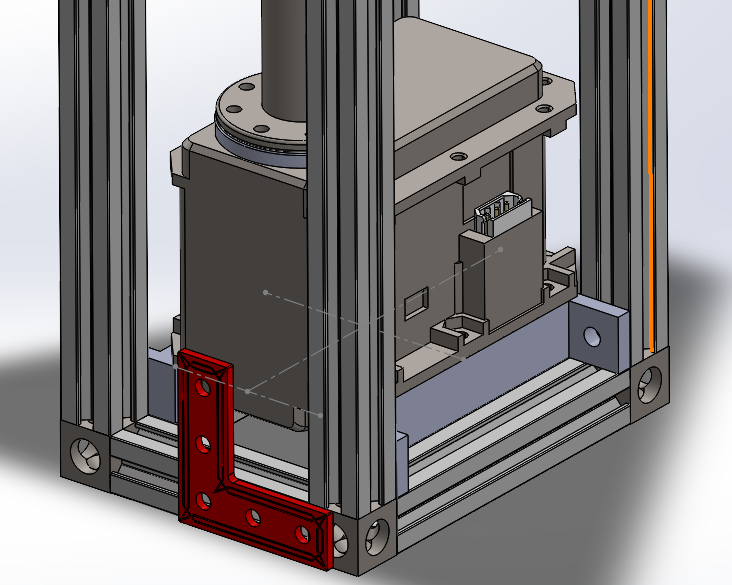
LaTeX/Figures/attache_glissière.png
