Raph1821/SpiRobs/LaTeX/Figures/cut_sketch.png

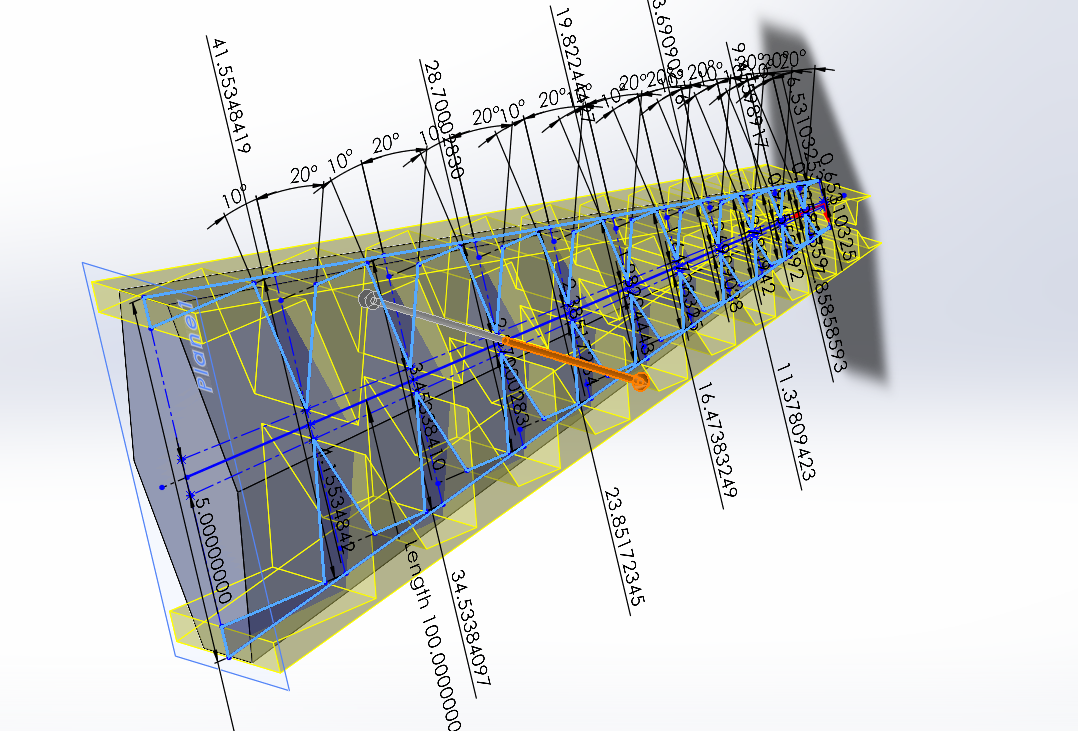
LaTeX/Figures/cut_sketch.png
