Raph1821/SpiRobs/LaTeX/Figures/ecrou_esquisse.png

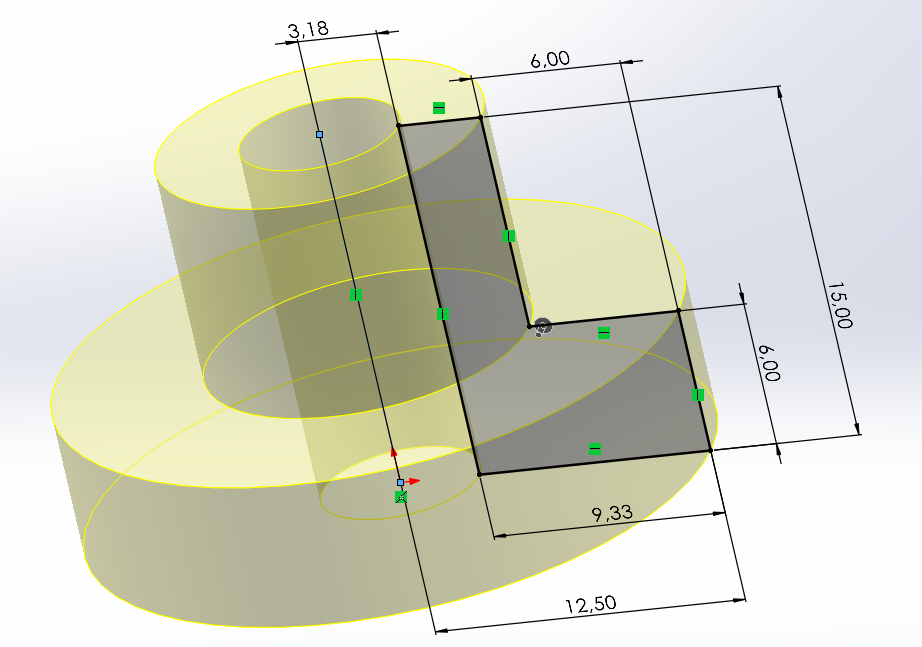
LaTeX/Figures/ecrou_esquisse.png
