Raph1821/SpiRobs/LaTeX/Figures/esquisse_etoile.png

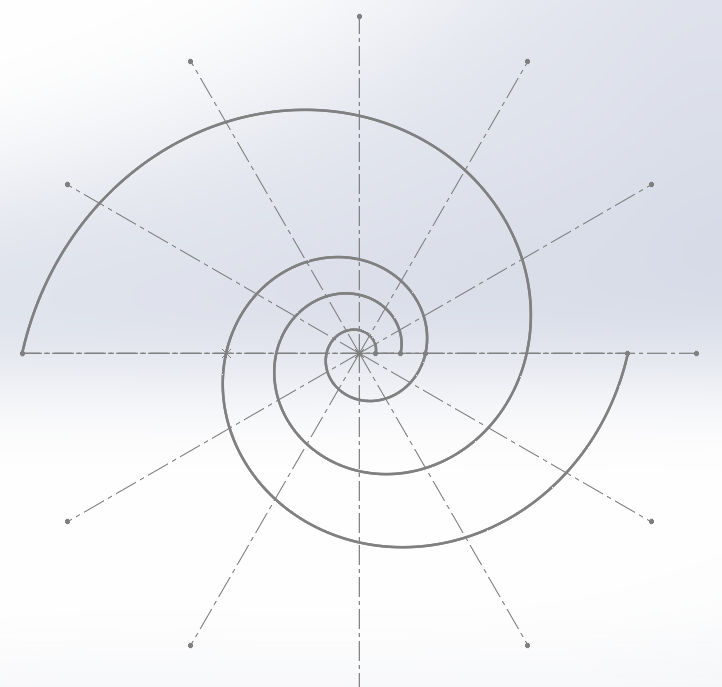
LaTeX/Figures/esquisse_etoile.png
