Raph1821/SpiRobs/LaTeX/Figures/esquisse_moitié_trapèze_3.png

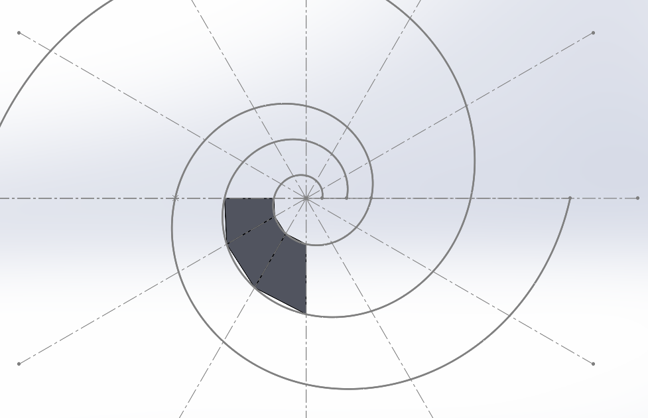
LaTeX/Figures/esquisse_moitié_trapèze_3.png
