Raph1821/SpiRobs/LaTeX/Figures/force_simulée.png

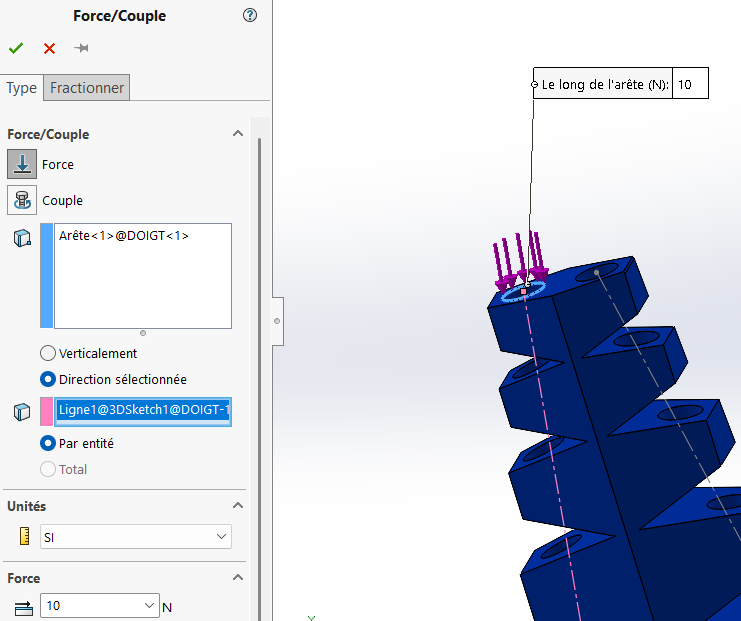
LaTeX/Figures/force_simulée.png
