Raph1821/SpiRobs/LaTeX/Figures/multi-stable.png

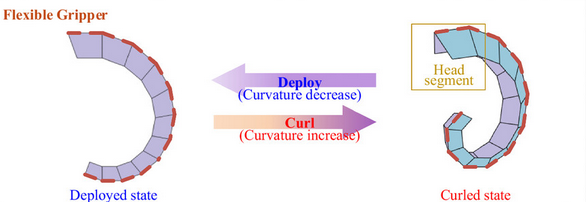
LaTeX/Figures/multi-stable.png
