Raph1821/SpiRobs/LaTeX/Figures/pb_simu1_base_molle.png

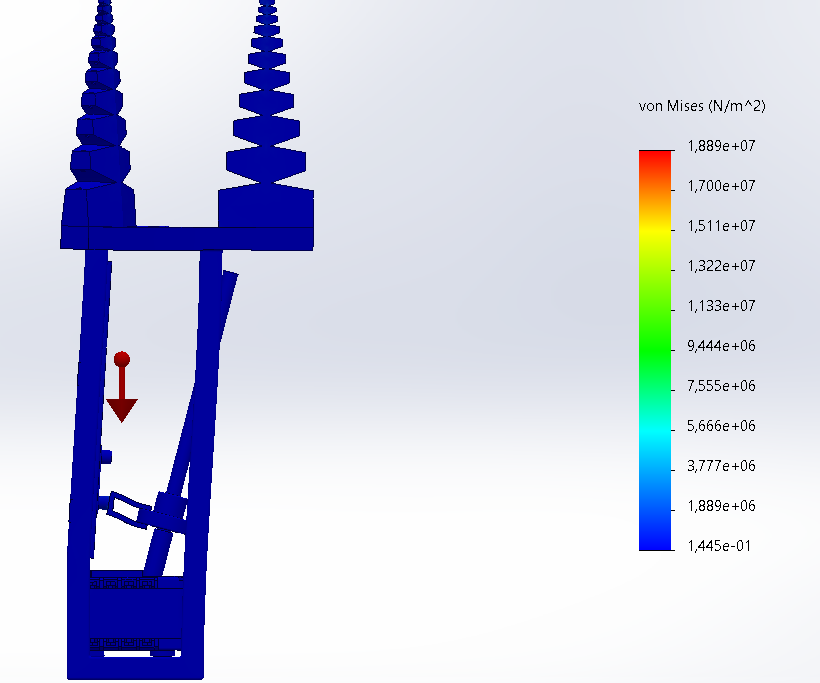
LaTeX/Figures/pb_simu1_base_molle.png
