Raph1821/SpiRobs/LaTeX/Figures/pb_simu1_base_molle_supp.PNG

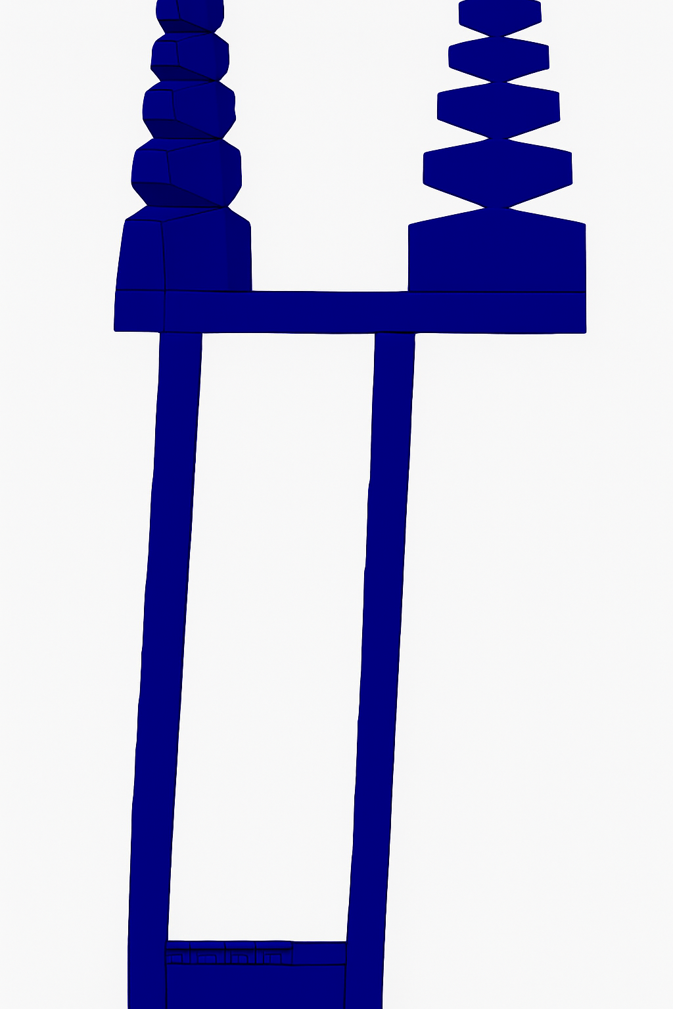
LaTeX/Figures/pb_simu1_base_molle_supp.PNG
