Raph1821/SpiRobs/LaTeX/Figures/poulies.jpg

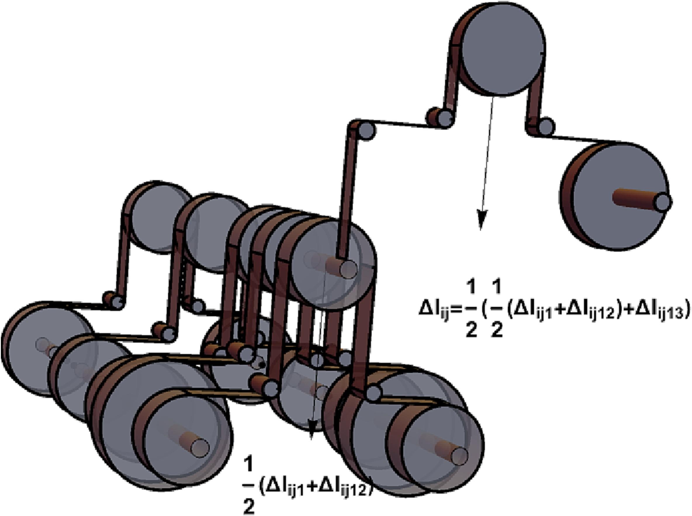
LaTeX/Figures/poulies.jpg
