Raph1821/SpiRobs/LaTeX/Figures/Scale_trapeze_2.png

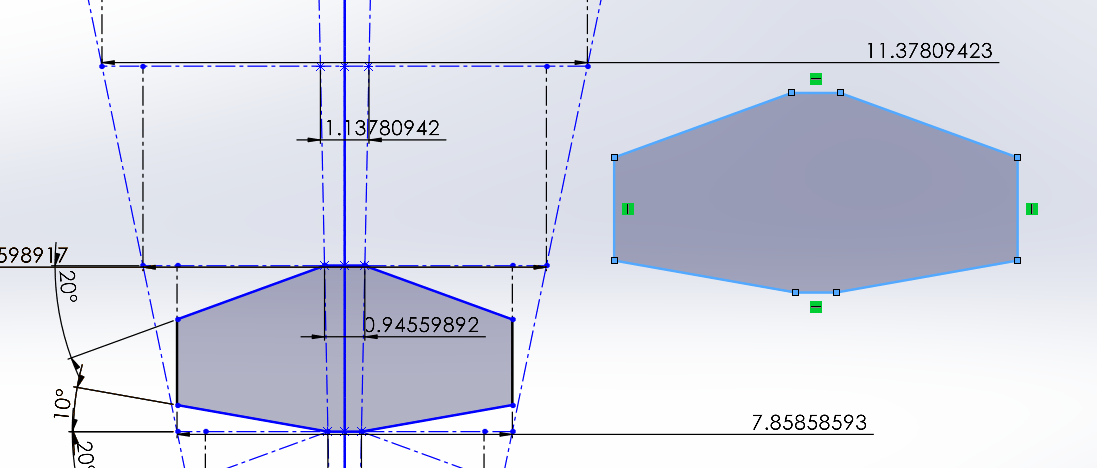
LaTeX/Figures/Scale_trapeze_2.png
