Raph1821/SpiRobs/LaTeX/Figures/spirale.png

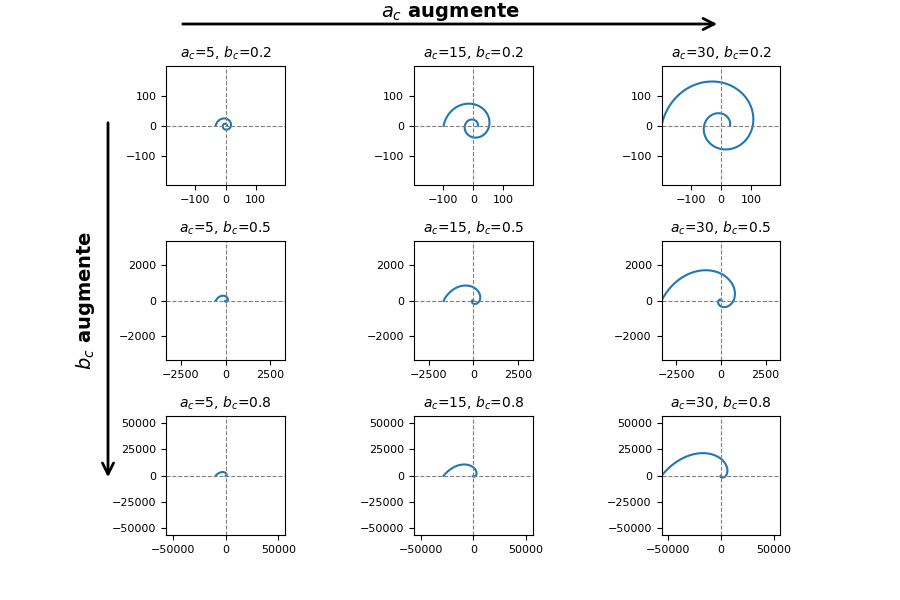
LaTeX/Figures/spirale.png
