Raph1821/SpiRobs/LaTeX/Figures/support_acheve.png

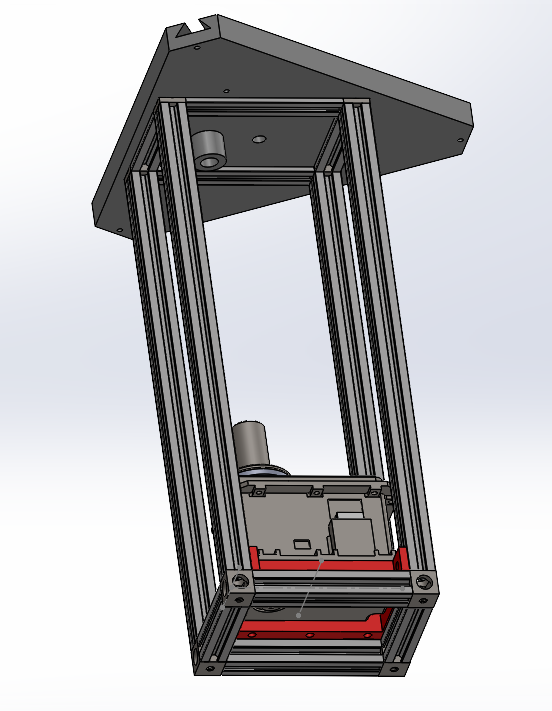
LaTeX/Figures/support_acheve.png
