Raph1821/SpiRobs/LaTeX/Figures/support_vis_moteur.png

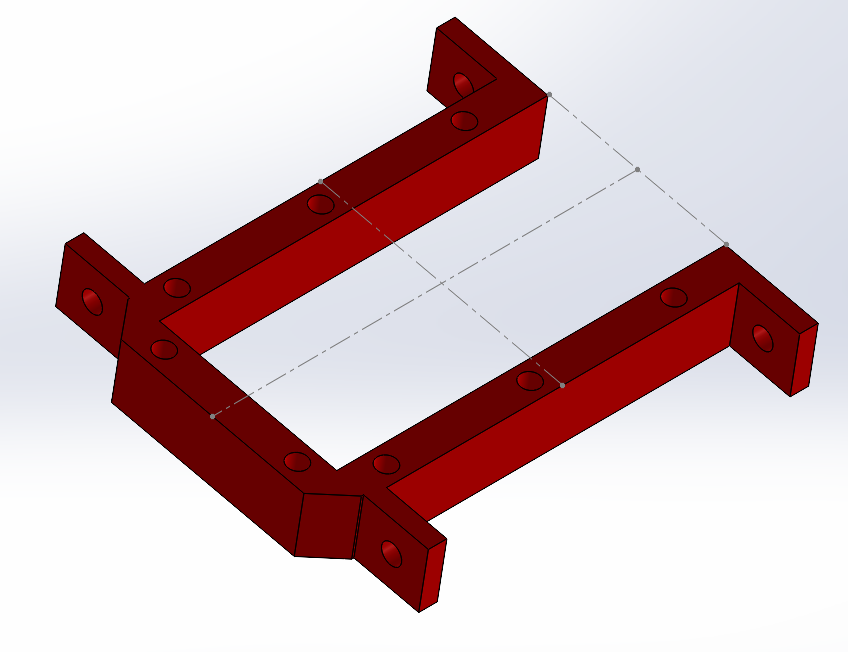
LaTeX/Figures/support_vis_moteur.png
