Raph1821/SpiRobs/LaTeX/Figures/tendon.png

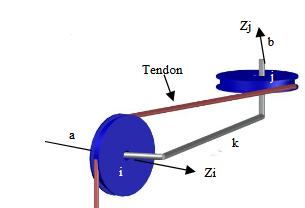
LaTeX/Figures/tendon.png
