Raph1821/SpiRobs/LaTeX/Figures/trou_doigt_cable.png

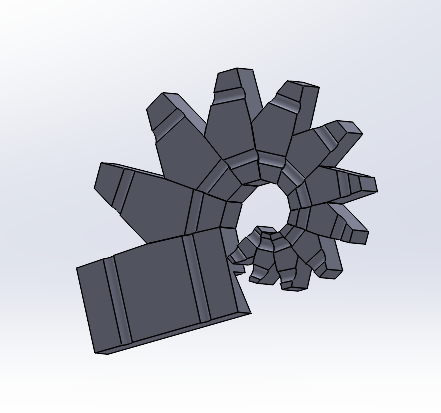
LaTeX/Figures/trou_doigt_cable.png
