Raph1821/SpiRobs/LaTeX/Figures/vis_simplifie.png

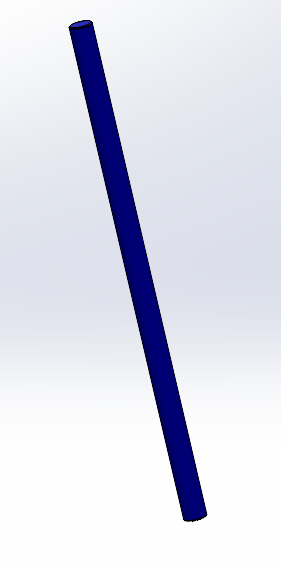
LaTeX/Figures/vis_simplifie.png
