Raph1821/SpiRobs/Solidworks/PINCE_SIMULATION-Statique 1/PINCE_SIMULATION.SLDASM

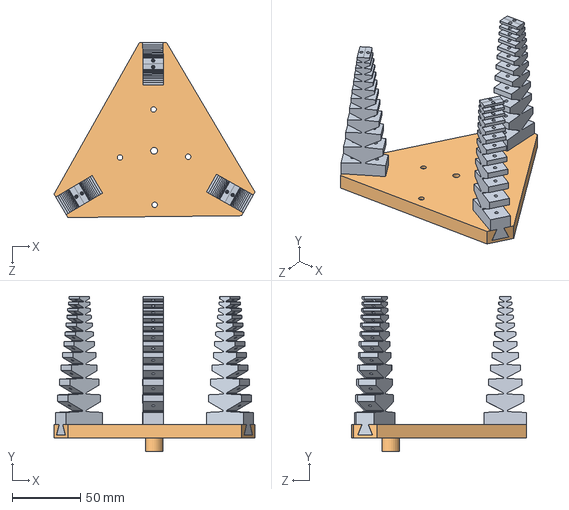
[picture p79: CAD file, 2025-07-01]
Solidworks/PINCE_SIMULATION-Statique 1/PINCE_SIMULATION.SLDASM
147.5 x 113.9 x 128.5 mm
BASE
DOIGT x 3
