Raph1821/SpiRobs/Solidworks/AX-12A/AX-12A.SLDASM

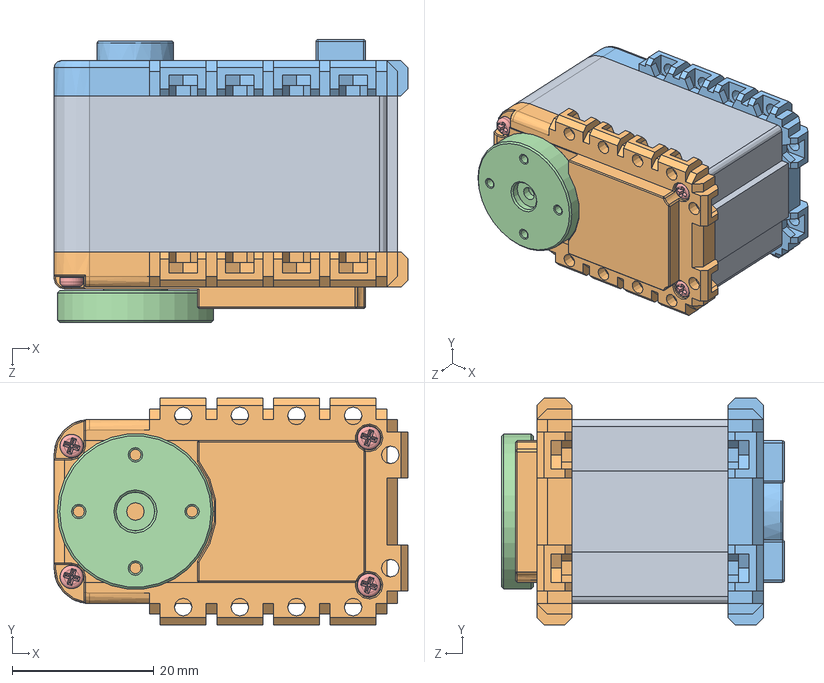
[picture p80: CAD file, 2025-06-17]
Solidworks/AX-12A/AX-12A.SLDASM
50.0 x 32.0 x 40.0 mm
AX-12A-01
AX-12A-02
AX-12A-03
AX-12A-04
SetScrew x 4
