Raph1821/SpiRobs/SLDPRT/spiral_flat_2.SLDPRT

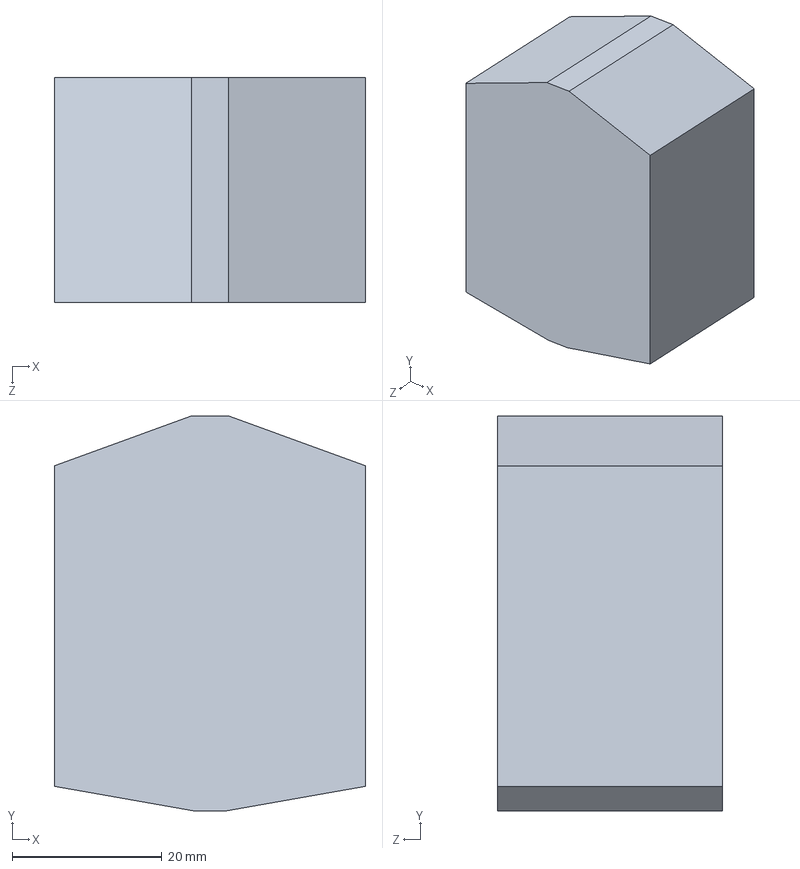
[picture p81: CAD file, 2025-06-20]
SLDPRT/spiral_flat_2.SLDPRT
41.6 x 52.7 x 30.0 mm
