Raph1821/SpiRobs/Solidworks/AX-12A/AX-12A-04.SLDPRT

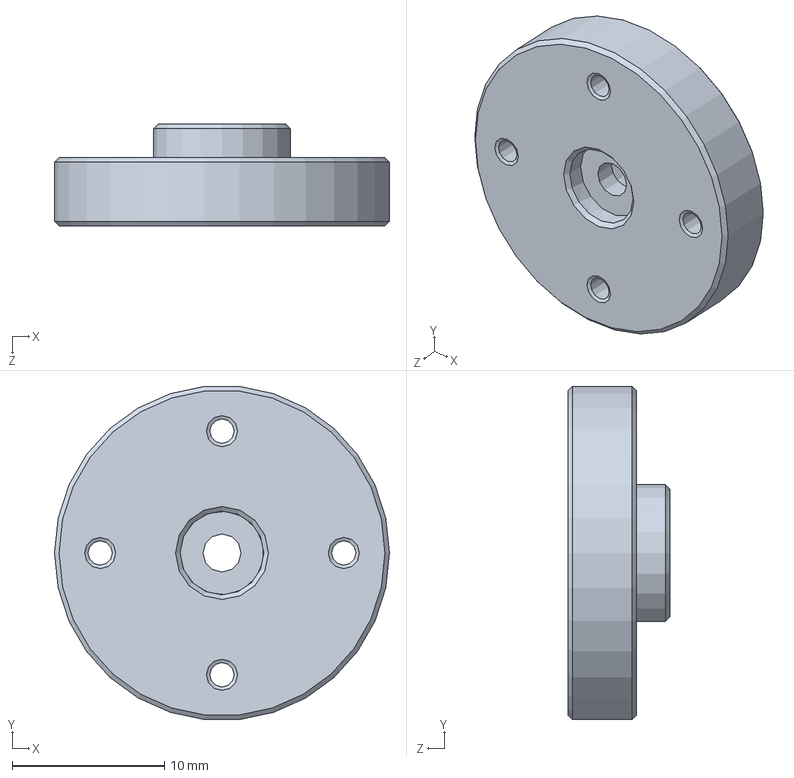
[picture p82: CAD file, 2025-06-17]
Solidworks/AX-12A/AX-12A-04.SLDPRT
22.0 x 21.9 x 6.70 mm
