Raph1821/SpiRobs/Solidworks/MAKERBEAM/BARRE_200.stp

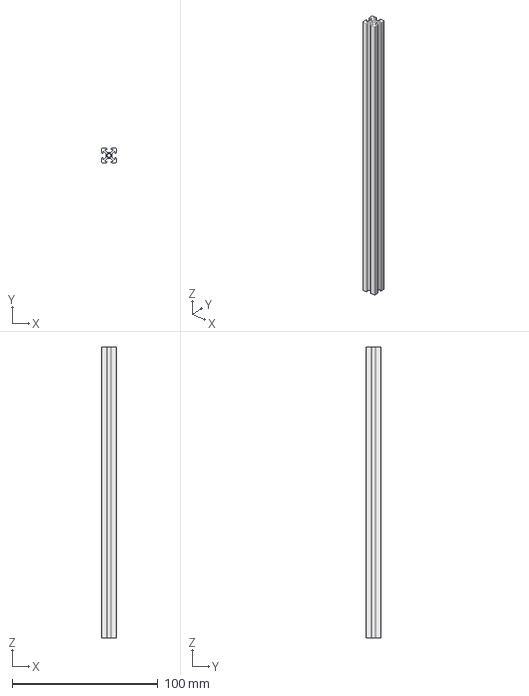
[picture p83: CAD file, 2025-06-20]
Solidworks/MAKERBEAM/BARRE_200.stp
10.0 x 10.0 x 200.0 mm
