Raph1821/SpiRobs/Solidworks/spirob2/DOIGT.SLDPRT

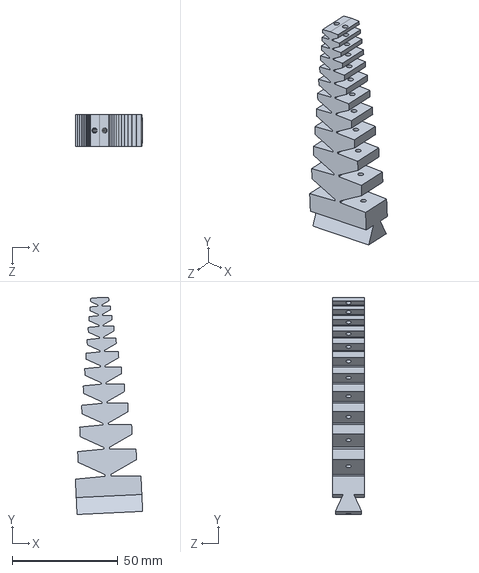
[picture p84: CAD file, 2025-07-03]
Solidworks/spirob2/DOIGT.SLDPRT
31.8 x 102.5 x 15.0 mm
