Raph1821/SpiRobs/Solidworks/VIS MERE.SLDPRT

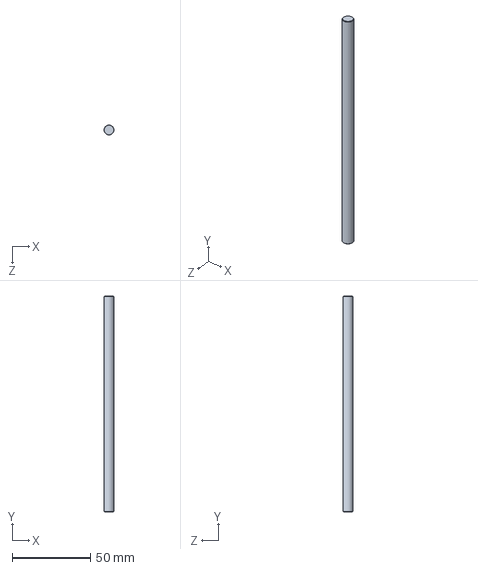
[picture p85: CAD file, 2025-07-07]
Solidworks/VIS MERE.SLDPRT
6.34 x 138.0 x 6.35 mm
