Raph1821/SpiRobs/Solidworks/AX-12A/AX-12A-01.SLDPRT

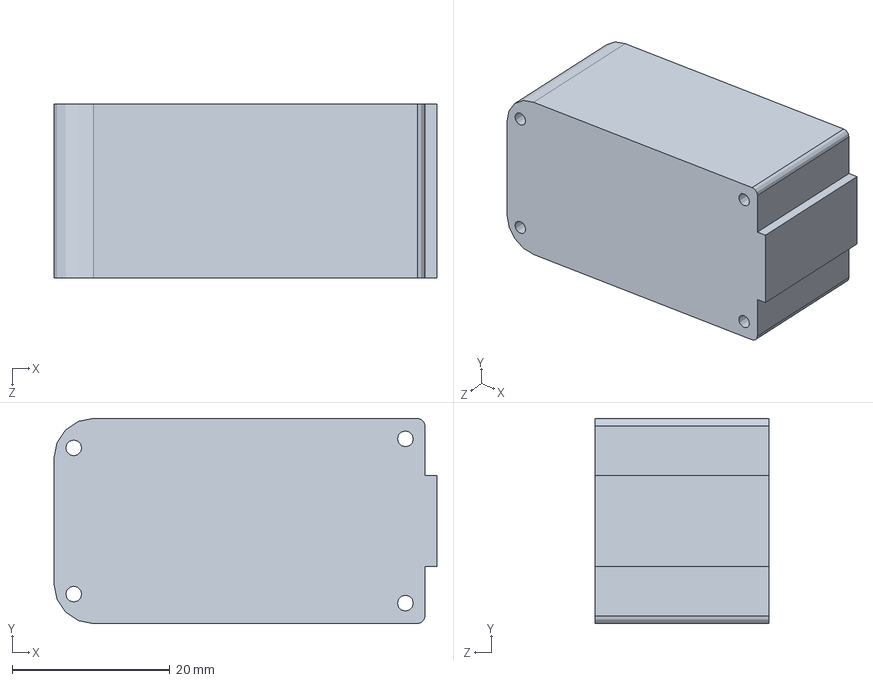
[picture p86: CAD file, 2025-06-17]
Solidworks/AX-12A/AX-12A-01.SLDPRT
48.5 x 26.0 x 22.0 mm
