Raph1821/SpiRobs/Solidworks/MAKERBEAM/BARRE_40.stp

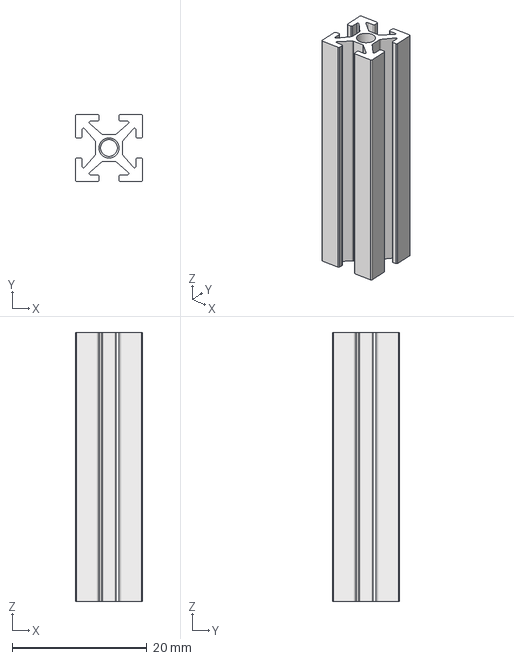
[picture p87: CAD file, 2025-06-19]
Solidworks/MAKERBEAM/BARRE_40.stp
10.0 x 10.0 x 40.0 mm
