Raph1821/SpiRobs/Solidworks/spirob2/Symétrie10.SLDPRT

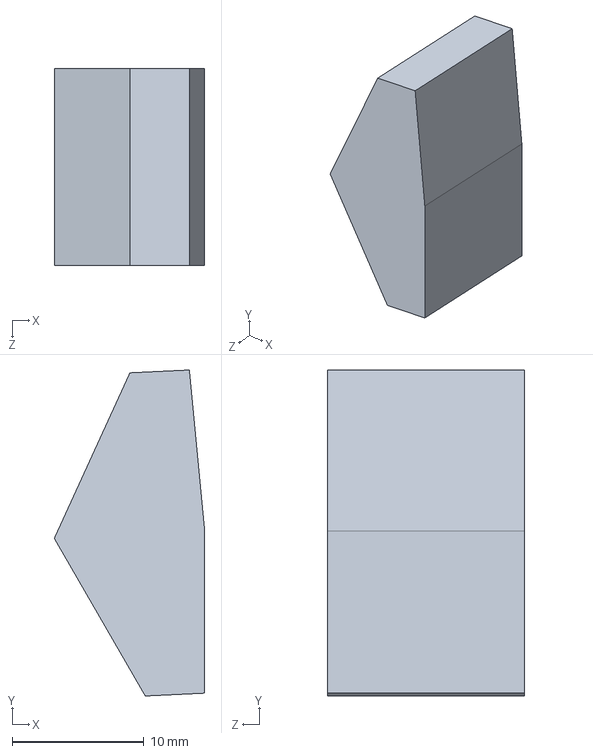
[picture p88: CAD file, 2025-06-28]
Solidworks/spirob2/Symétrie10.SLDPRT
11.4 x 24.8 x 15.0 mm
