Raph1821/SpiRobs/Solidworks/MAKERBEAM/BARRE_60.stp

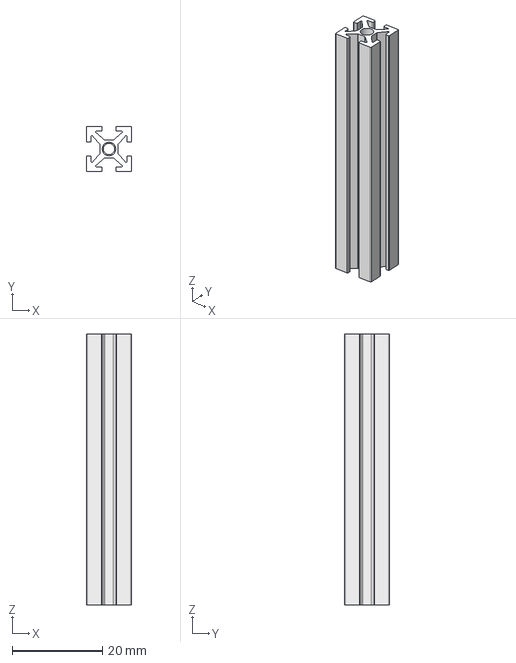
[picture p90: CAD file, 2025-06-19]
Solidworks/MAKERBEAM/BARRE_60.stp
10.0 x 10.0 x 60.0 mm
