Raph1821/SpiRobs/SLDPRT/spiral_flat.SLDPRT

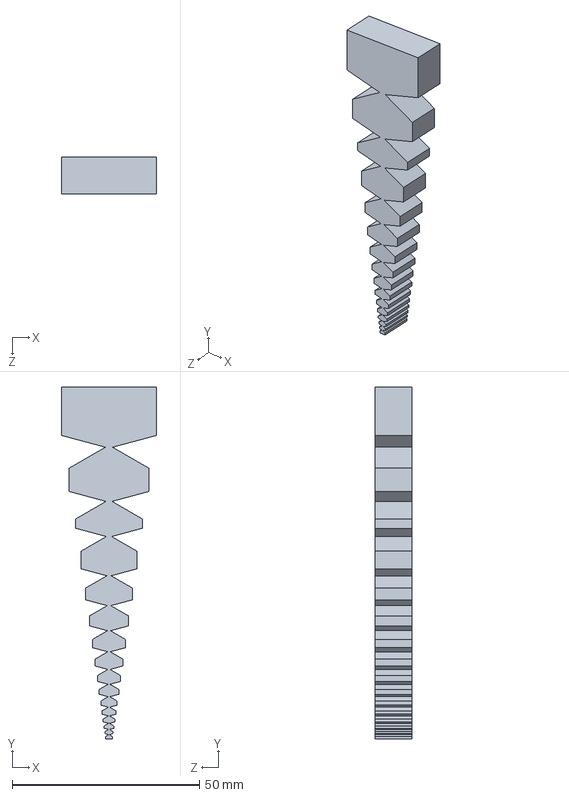
[picture p91: CAD file, 2025-06-13]
SLDPRT/spiral_flat.SLDPRT
25.3 x 94.0 x 10.0 mm
