Raph1821/SpiRobs/Solidworks/ATTACHE.SLDPRT

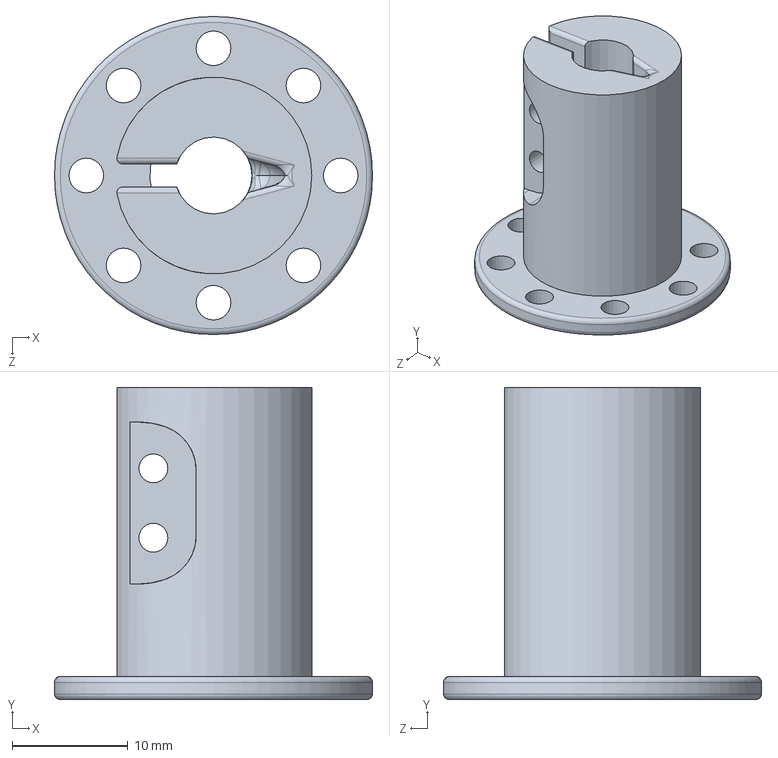
[picture p92: CAD file, 2025-07-07]
Solidworks/ATTACHE.SLDPRT
27.5 x 27.0 x 27.5 mm
