Raph1821/SpiRobs/Solidworks/MAKERBEAM/BARRE_300.stp

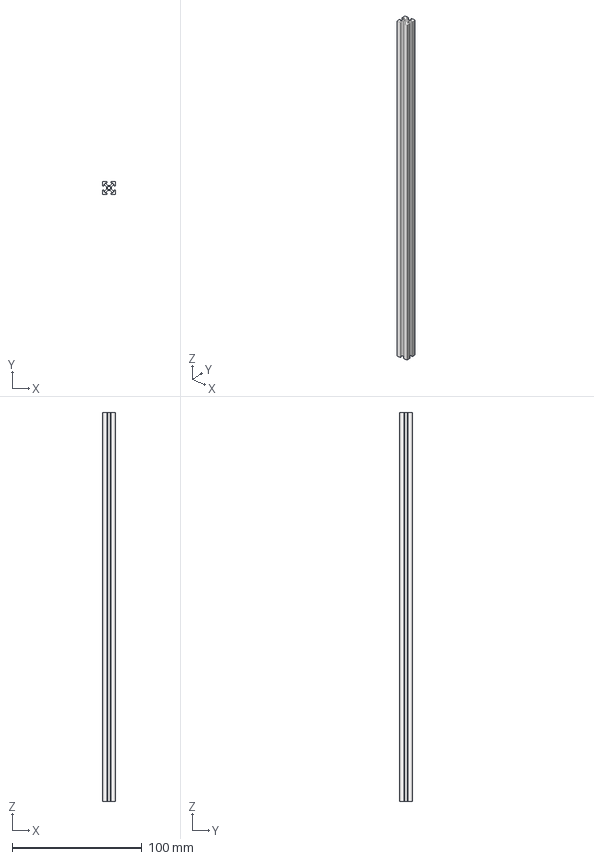
[picture p93: CAD file, 2025-06-19]
Solidworks/MAKERBEAM/BARRE_300.stp
10.0 x 10.0 x 300.0 mm
