Raph1821/SpiRobs/Solidworks/spirob2/Symétrie1.SLDPRT

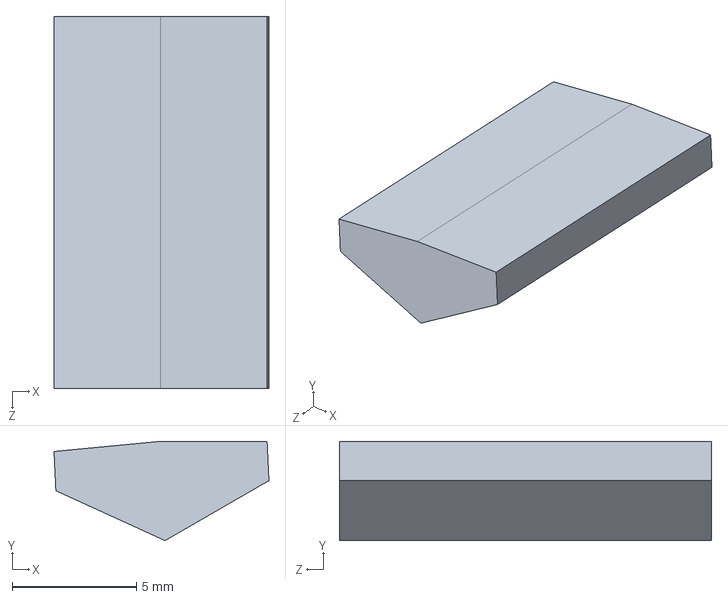
[picture p94: CAD file, 2025-06-28]
Solidworks/spirob2/Symétrie1.SLDPRT
8.66 x 4.00 x 15.0 mm
