Raph1821/SpiRobs/Solidworks/AX-12A/AX-12A-02.SLDPRT

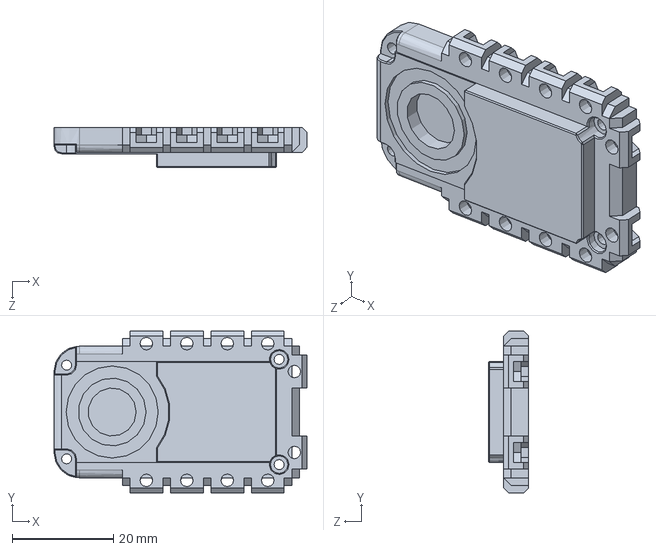
[picture p95: CAD file, 2025-06-17]
Solidworks/AX-12A/AX-12A-02.SLDPRT
50.0 x 32.0 x 8.00 mm
