Raph1821/SpiRobs/Solidworks/LINK.SLDPRT

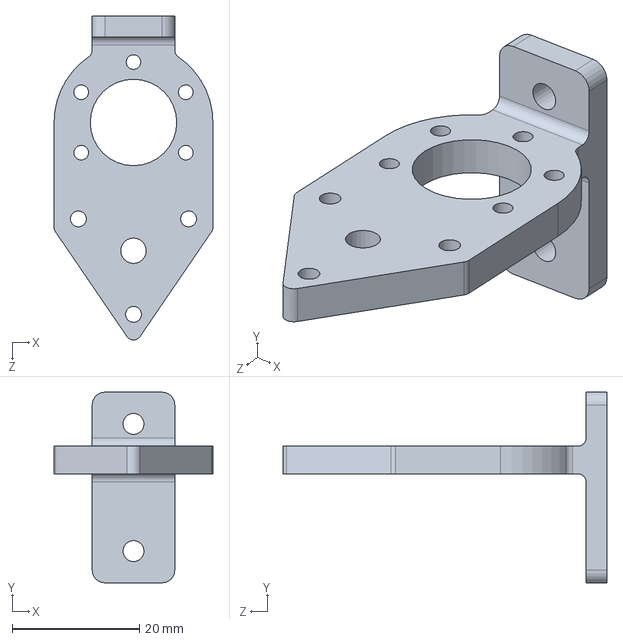
[picture p96: CAD file, 2025-07-05]
Solidworks/LINK.SLDPRT
25.0 x 30.0 x 51.0 mm
