Raph1821/SpiRobs/Solidworks/MAKERBEAM/BARRE_100.stp

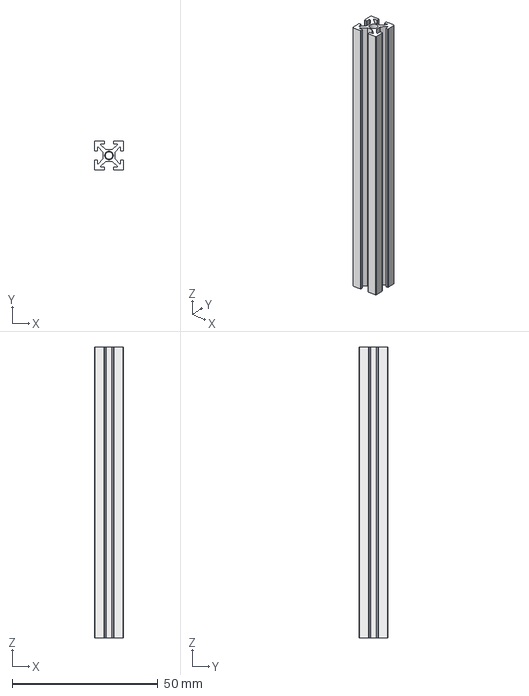
[picture p97: CAD file, 2025-06-19]
Solidworks/MAKERBEAM/BARRE_100.stp
10.0 x 10.0 x 100.0 mm
