Raph1821/SpiRobs/Solidworks/MAKERBEAM/CORNER.stp

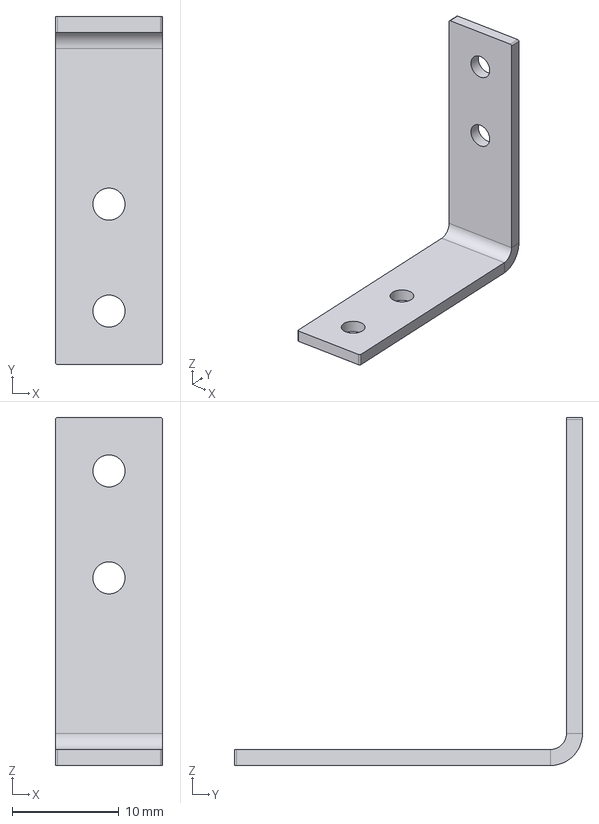
[picture p98: CAD file, 2025-06-19]
Solidworks/MAKERBEAM/CORNER.stp
10.0 x 32.6 x 32.6 mm
