Raph1821/SpiRobs/Solidworks/spirob2/Symétrie9.SLDPRT

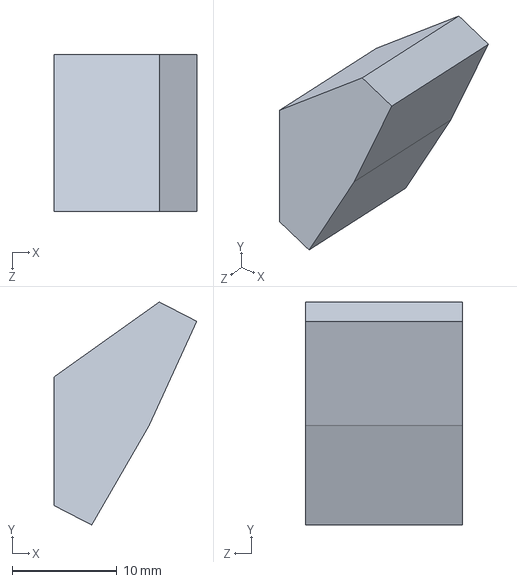
[picture p99: CAD file, 2025-06-28]
Solidworks/spirob2/Symétrie9.SLDPRT
13.6 x 21.3 x 15.0 mm
