Raph1821/SpiRobs/Solidworks/SUPPORT_DE_MOTEUR.SLDPRT

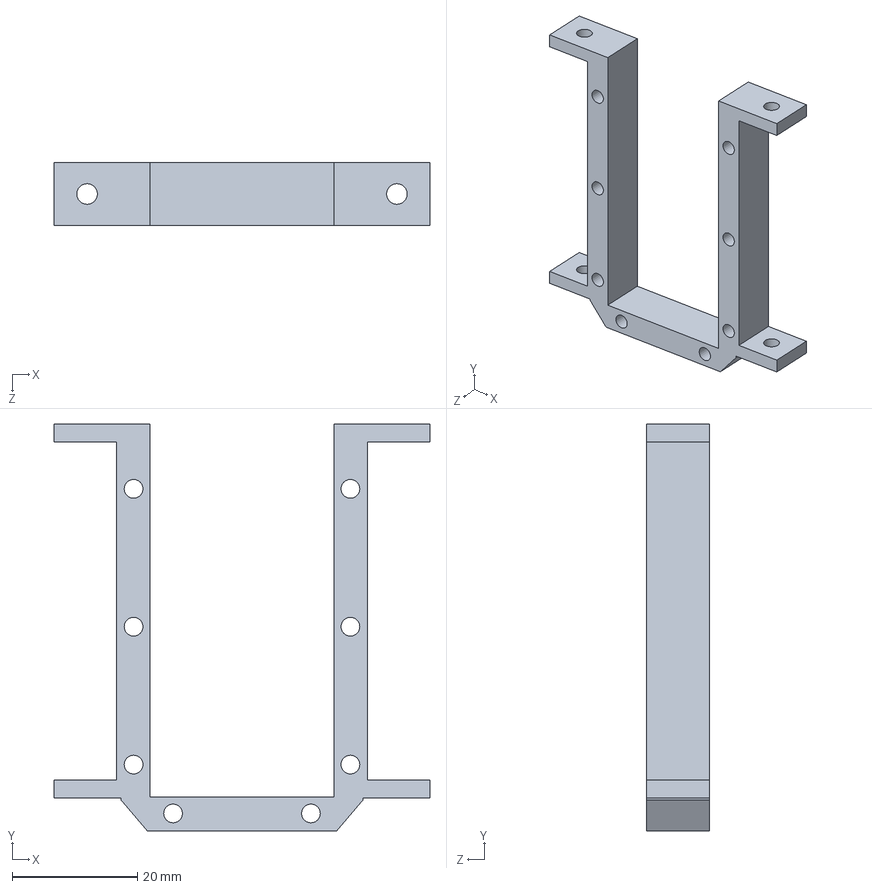
[picture p100: CAD file, 2025-07-01]
Solidworks/SUPPORT_DE_MOTEUR.SLDPRT
60.0 x 64.9 x 10.0 mm
