Raph1821/SpiRobs/Solidworks/MAKERBEAM/BARRE_150.stp

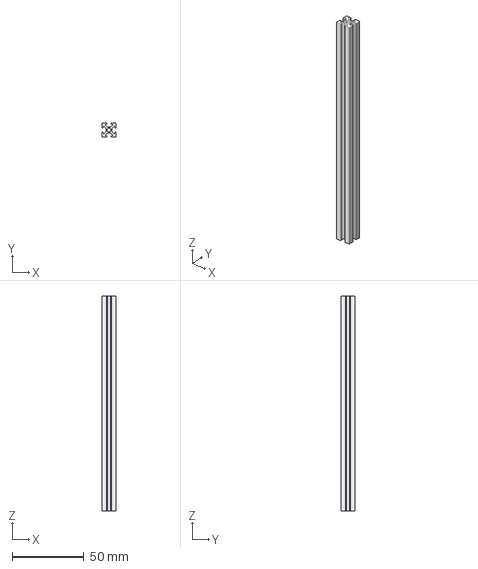
[picture p101: CAD file, 2025-06-19]
Solidworks/MAKERBEAM/BARRE_150.stp
10.0 x 10.0 x 150.0 mm
