Raph1821/SpiRobs/Solidworks/POMME.SLDPRT

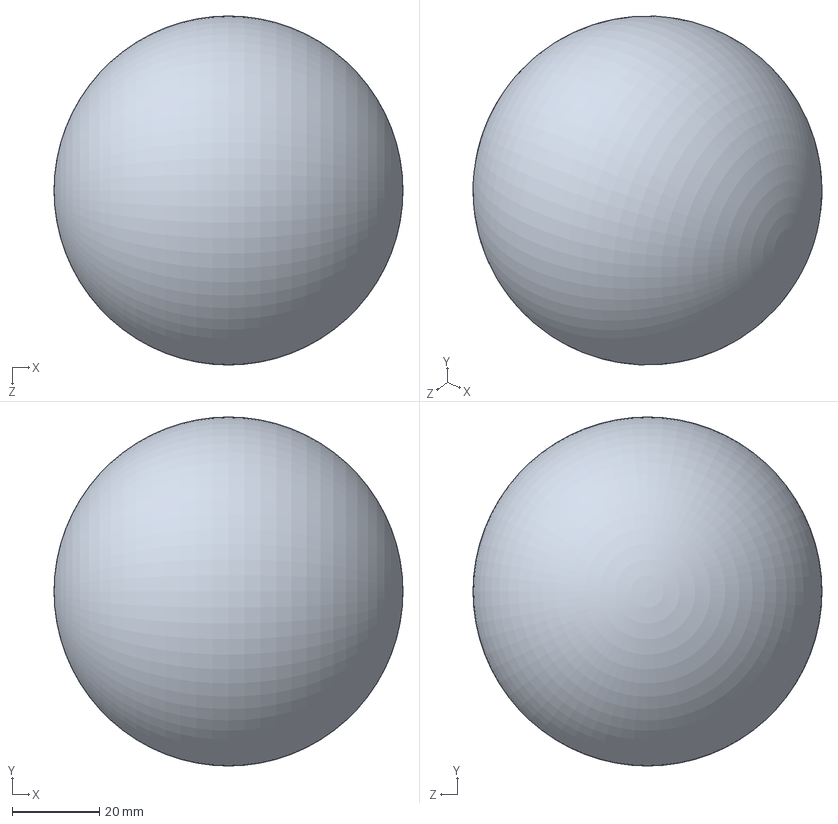
[picture p102: CAD file, 2025-06-28]
Solidworks/POMME.SLDPRT
80.0 x 80.0 x 80.0 mm
