Raph1821/SpiRobs/Solidworks/spirob2/Symétrie5.SLDPRT

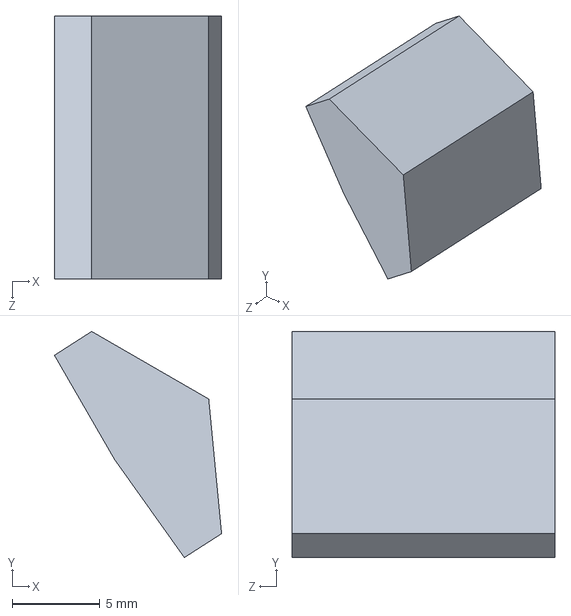
[picture p103: CAD file, 2025-06-28]
Solidworks/spirob2/Symétrie5.SLDPRT
9.53 x 12.9 x 15.0 mm
