Raph1821/SpiRobs/Solidworks/BASE.SLDPRT

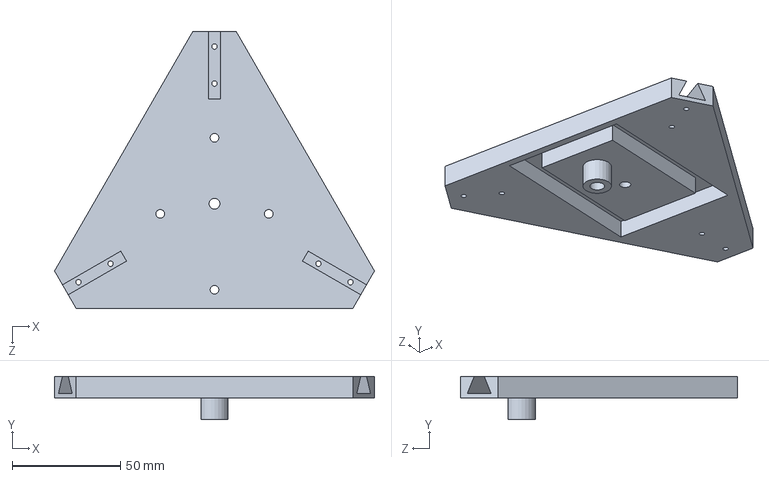
[picture p104: CAD file, 2025-06-28]
Solidworks/BASE.SLDPRT
147.5 x 20.0 x 127.7 mm
