Raph1821/SpiRobs/Solidworks/MAKERBEAM/CUBE.stp

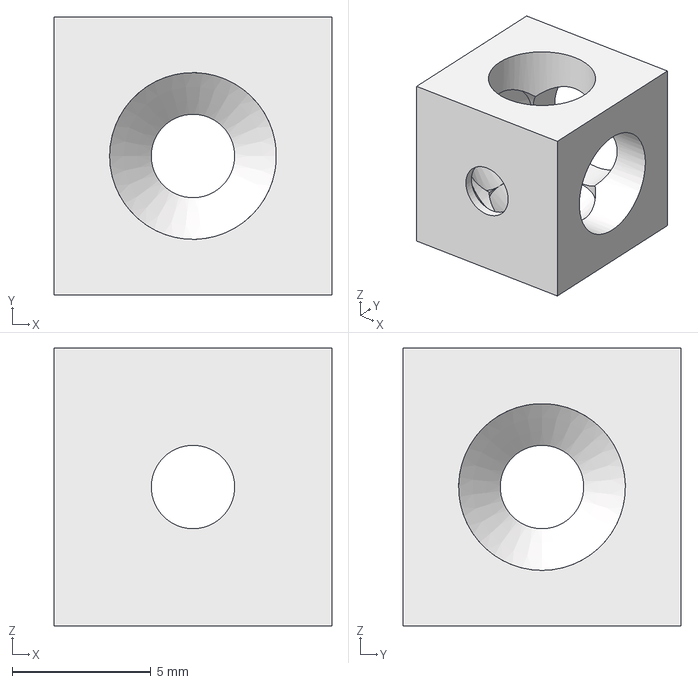
[picture p105: CAD file, 2025-06-19]
Solidworks/MAKERBEAM/CUBE.stp
10.0 x 10.0 x 10.0 mm
