Raph1821/SpiRobs/Solidworks/spirob2/Symétrie11.SLDPRT

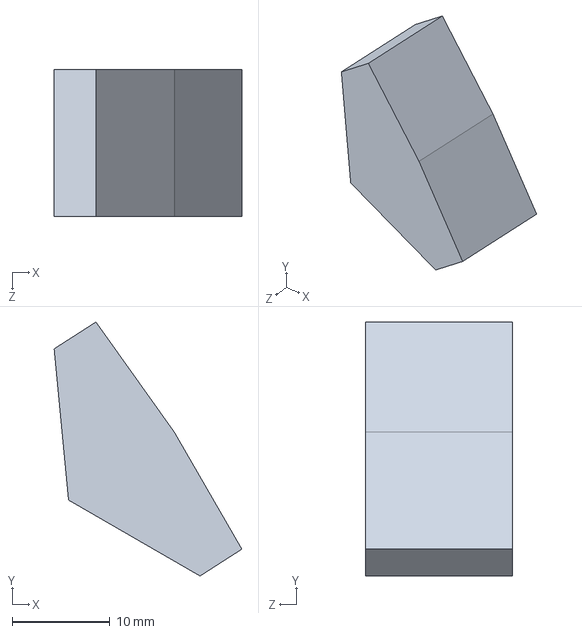
[picture p106: CAD file, 2025-06-28]
Solidworks/spirob2/Symétrie11.SLDPRT
19.2 x 26.0 x 15.0 mm
