Raph1821/SpiRobs/Solidworks/GLISSIERE.SLDPRT

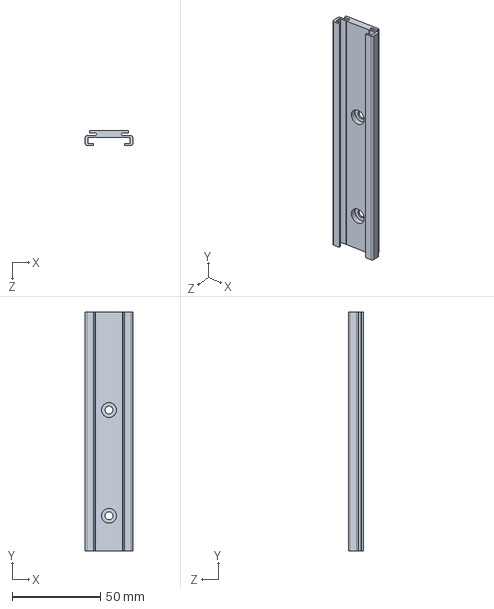
[picture p107: CAD file, 2025-06-24]
Solidworks/GLISSIERE.SLDPRT
27.0 x 135.6 x 8.70 mm
