Raph1821/SpiRobs/Solidworks/MAKERBEAM/60_DEGREE.stp

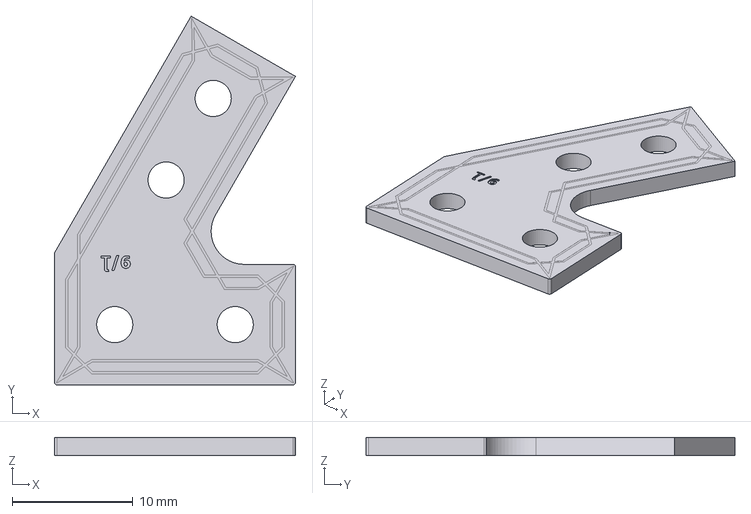
[picture p108: CAD file, 2025-06-19]
Solidworks/MAKERBEAM/60_DEGREE.stp
20.0 x 30.6 x 1.50 mm
