Raph1821/SpiRobs/Solidworks/spirob2/Symétrie4.SLDPRT

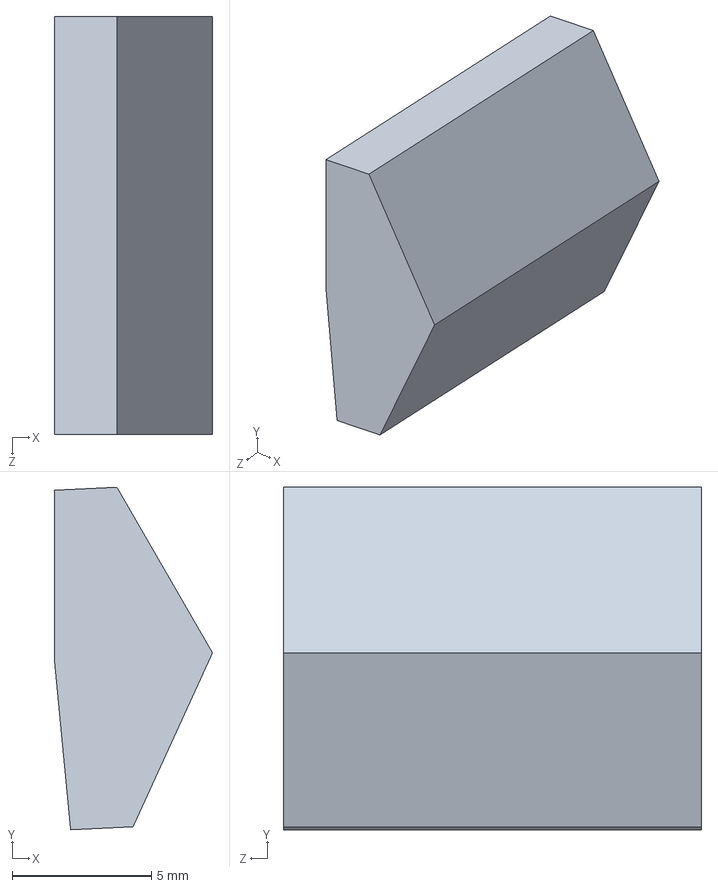
[picture p109: CAD file, 2025-06-28]
Solidworks/spirob2/Symétrie4.SLDPRT
5.67 x 12.3 x 15.0 mm
