Raph1821/SpiRobs/Solidworks/ECROU.SLDPRT

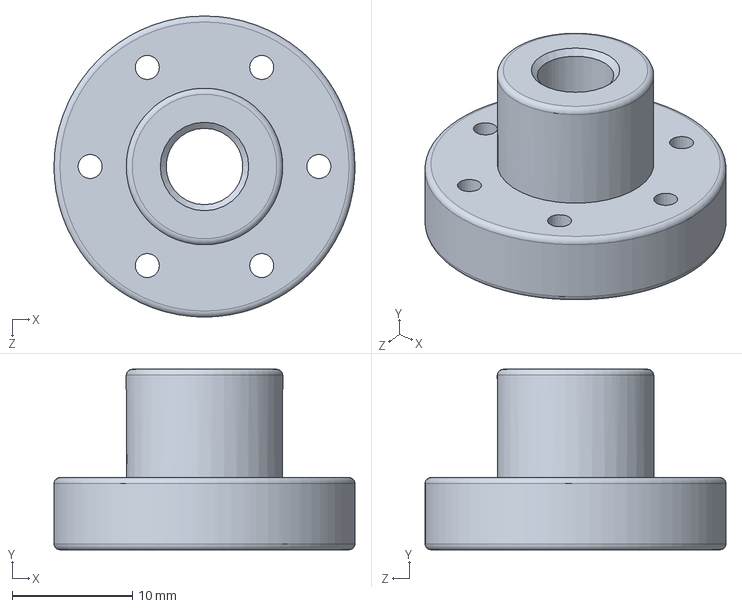
[picture p110: CAD file, 2025-06-24]
Solidworks/ECROU.SLDPRT
25.0 x 15.0 x 25.0 mm
