Raph1821/SpiRobs/Solidworks/MAKERBEAM/RIGHT_ANGLE.stp

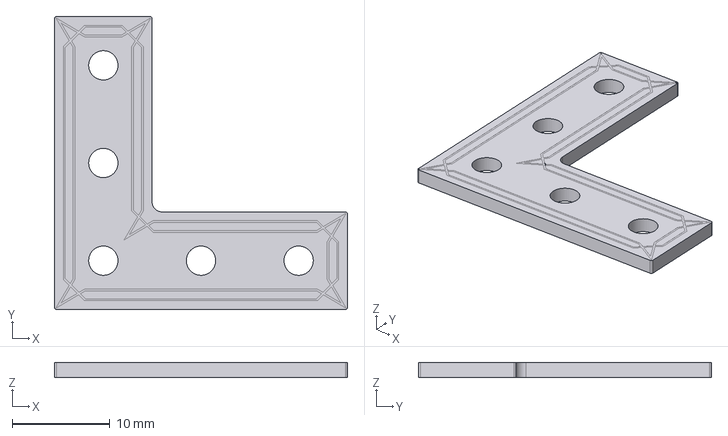
[picture p111: CAD file, 2025-06-19]
Solidworks/MAKERBEAM/RIGHT_ANGLE.stp
30.0 x 30.0 x 1.50 mm
