Raph1821/SpiRobs/Solidworks/spirob2/Symétrie6.SLDPRT

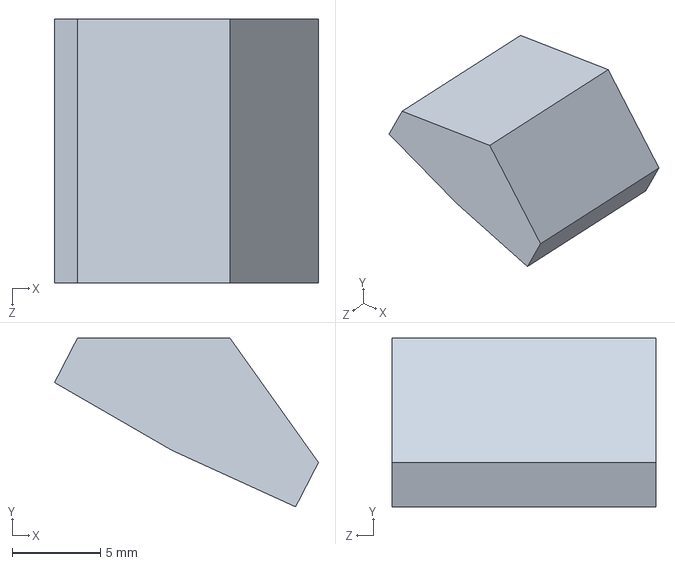
[picture p112: CAD file, 2025-06-28]
Solidworks/spirob2/Symétrie6.SLDPRT
15.0 x 9.58 x 15.0 mm
