Raph1821/SpiRobs/Solidworks/CHARIOT.stp

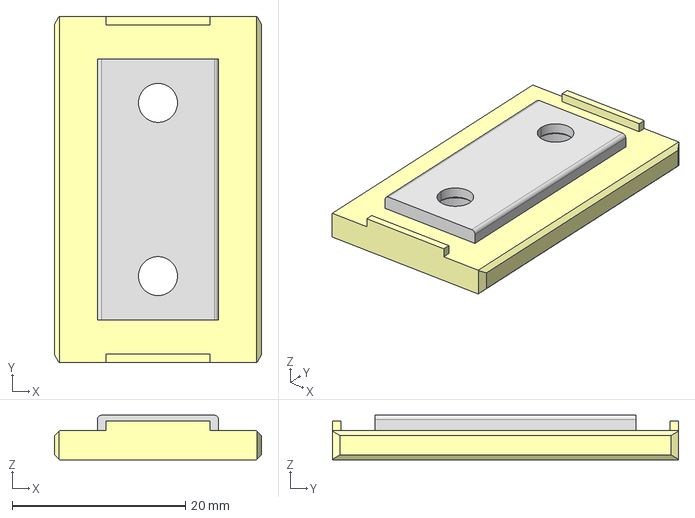
[picture p113: CAD file, 2025-06-20]
Solidworks/CHARIOT.stp
23.9 x 40.0 x 5.15 mm
