Raph1821/SpiRobs/Solidworks/spirob2/Symétrie7.SLDPRT

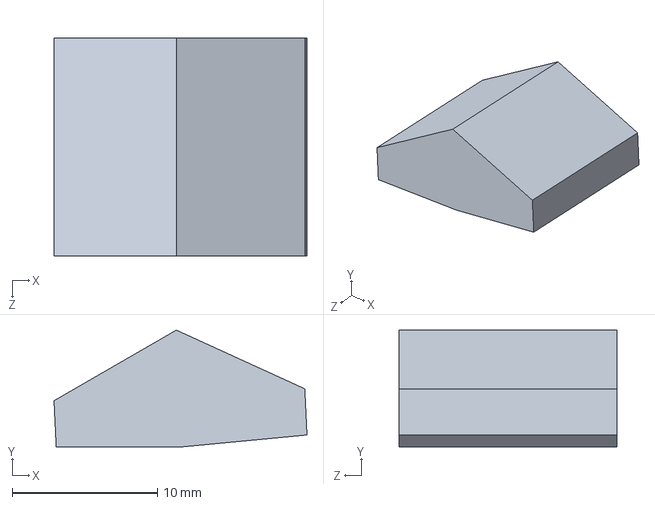
[picture p114: CAD file, 2025-06-28]
Solidworks/spirob2/Symétrie7.SLDPRT
17.4 x 8.05 x 15.0 mm
