Raph1821/SpiRobs/Solidworks/MAKERBEAM/45_DEGREE.stp

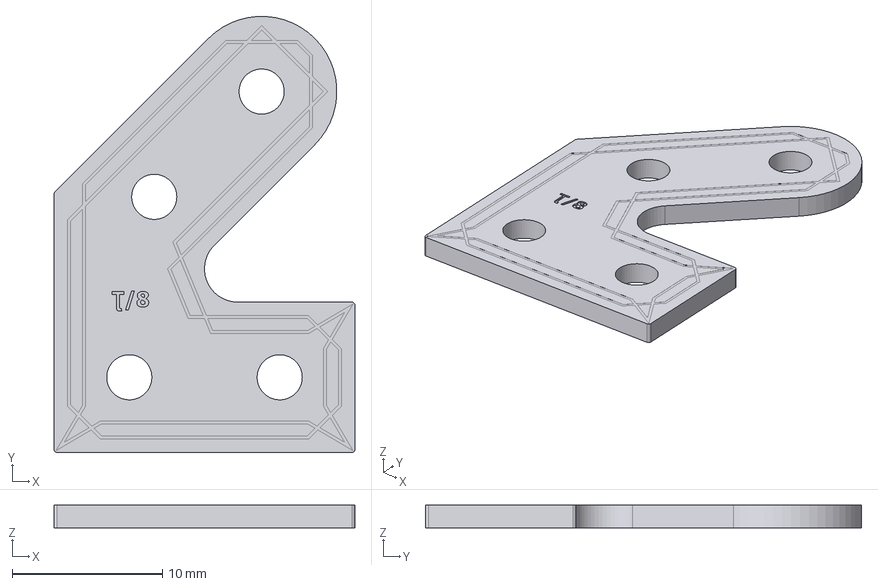
[picture p115: CAD file, 2025-06-19]
Solidworks/MAKERBEAM/45_DEGREE.stp
20.0 x 29.0 x 1.50 mm
