Raph1821/SpiRobs/Solidworks/MX-106.STEP

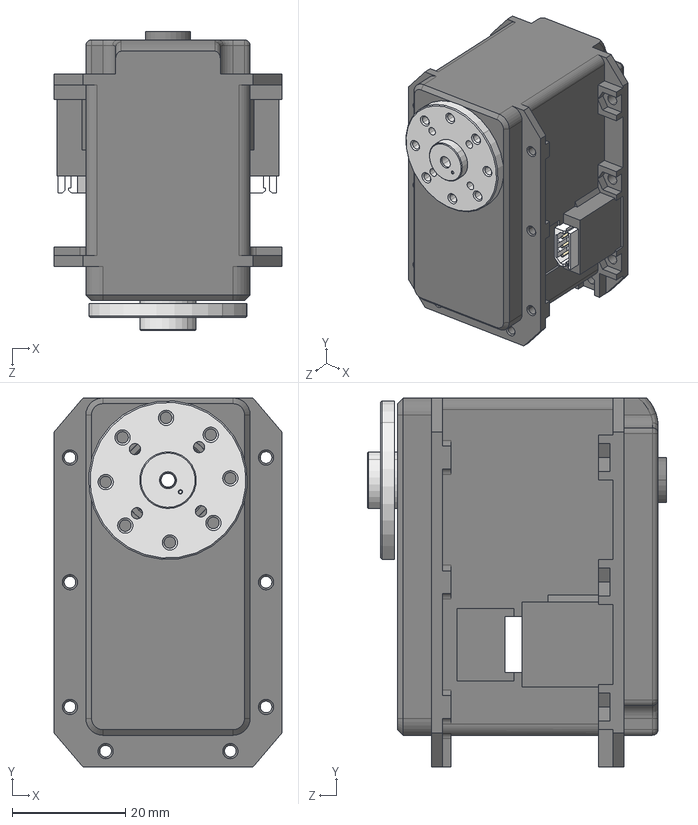
[picture p116: CAD file, 2025-06-19]
Solidworks/MX-106.STEP
40.2 x 65.1 x 52.8 mm
MX-106T
ROUE MX106T
arbre MX106T
Insert M3 à encastrer long 5mm
connecteur dynamixel x 2
