Raph1821/SpiRobs/Solidworks/spirob2/Symétrie12.SLDPRT

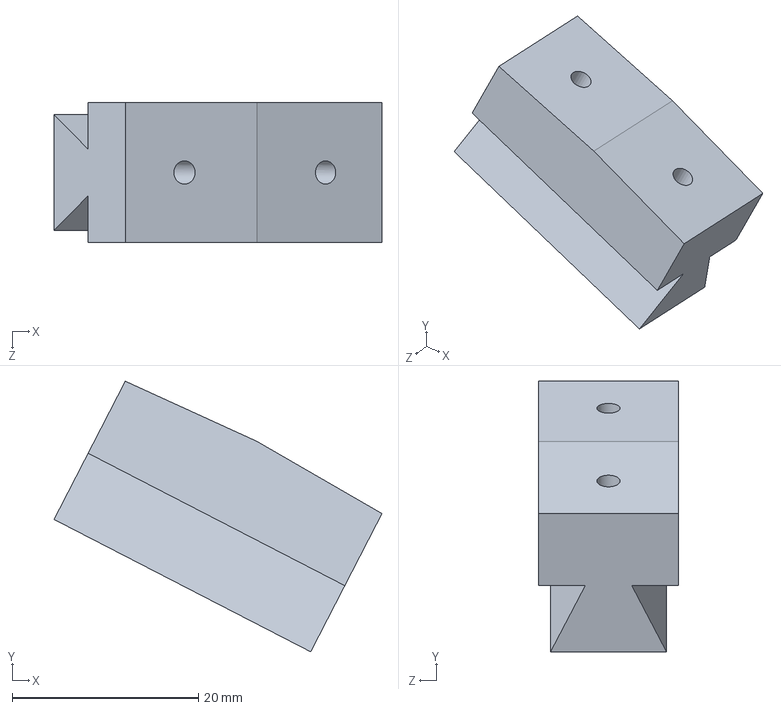
[picture p117: CAD file, 2025-06-28]
Solidworks/spirob2/Symétrie12.SLDPRT
35.3 x 29.1 x 15.0 mm
