Raph1821/SpiRobs/Solidworks/spirob2/Symétrie8.SLDPRT

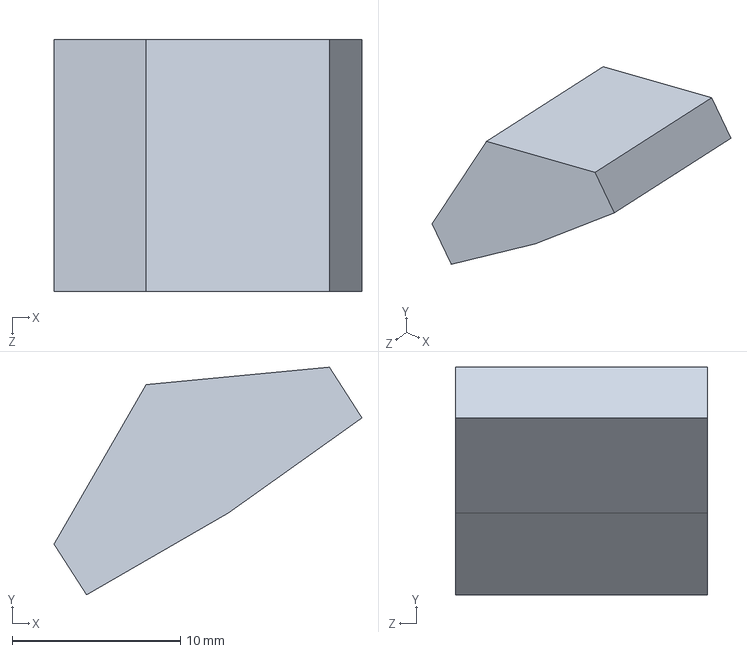
[picture p118: CAD file, 2025-06-28]
Solidworks/spirob2/Symétrie8.SLDPRT
18.3 x 13.5 x 15.0 mm
