Raph1821/SpiRobs/Solidworks/spirob2/Symétrie3.SLDPRT

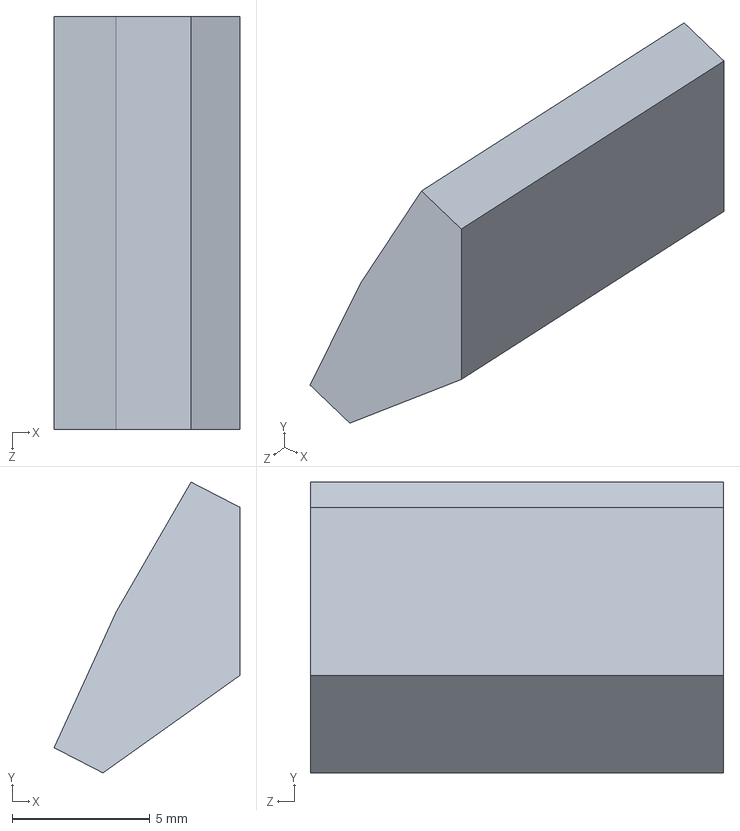
[picture p119: CAD file, 2025-06-28]
Solidworks/spirob2/Symétrie3.SLDPRT
6.75 x 10.6 x 15.0 mm
