Raph1821/SpiRobs/Solidworks/spirob2/Symétrie2.SLDPRT

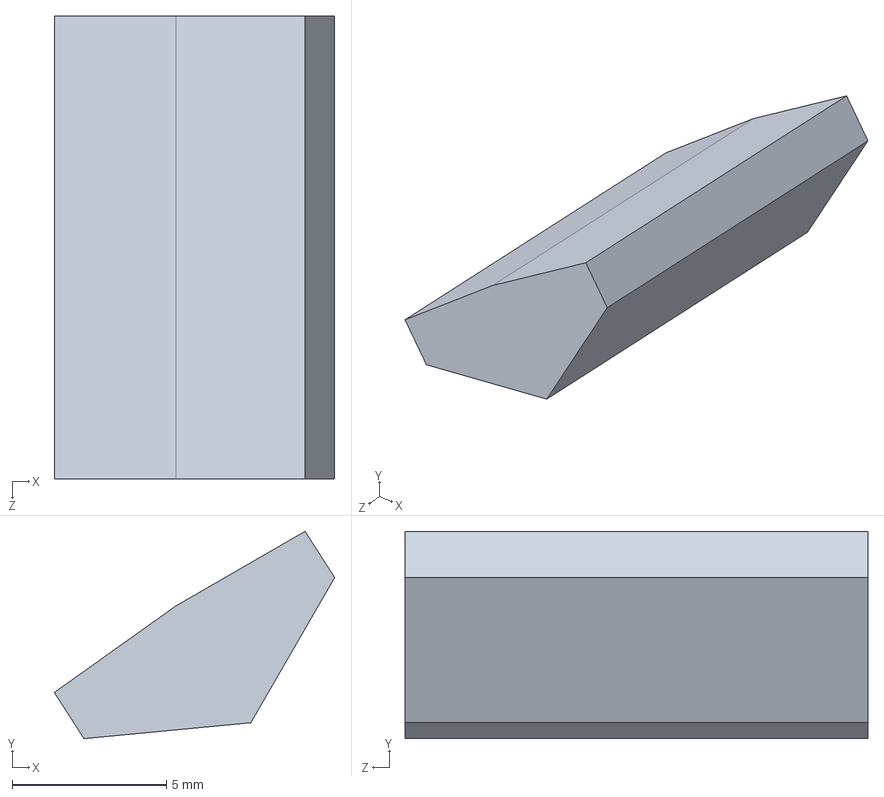
[picture p120: CAD file, 2025-06-28]
Solidworks/spirob2/Symétrie2.SLDPRT
9.09 x 6.72 x 15.0 mm
