Raph1821/SpiRobs/Solidworks/spirob2/spirale_enroulée.SLDPRT

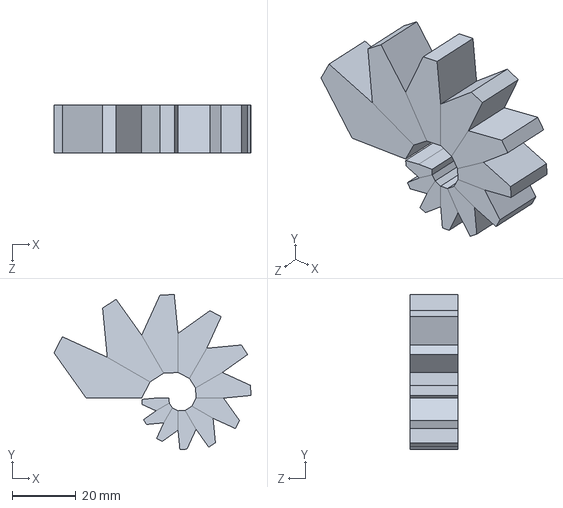
[picture p121: CAD file, 2025-06-28]
Solidworks/spirob2/spirale_enroulée.SLDPRT
62.0 x 48.8 x 15.0 mm
