Raph1821/SpiRobs/Solidworks/SUPPORT.SLDASM

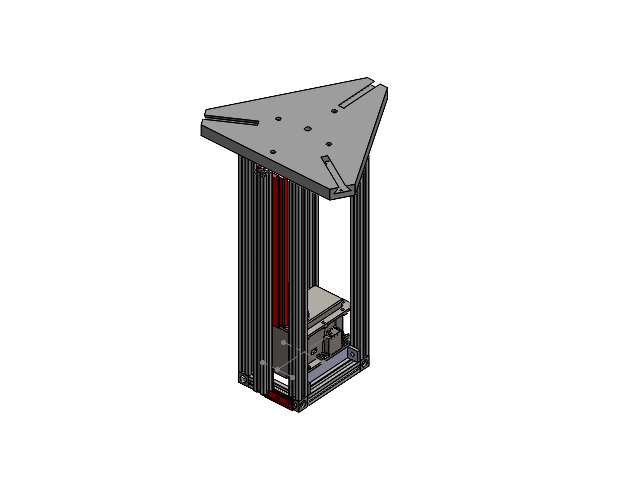
[picture p123: CAD file, 2025-07-07]
Solidworks/SUPPORT.SLDASM
BASE
MX-106T.STEP
ROUE MX106T.STEP
arbre MX106T.STEP
Insert M3 _ encastrer long 5mm.STEP
connecteur dynamixel.STEP x 2
BARRE_60.stp x 4
BARRE_40.stp x 4
CUBE.stp x 8
ATTACHE
BARRE_200.stp x 5
SUPPORT_DE_MOTEUR
GLISSIERE
RIGHT_ANGLE.stp
