Raph1821/SpiRobs/(list of files, cad)

Other CAD files:
SLDPRT/spiral_flat_sketch.SLDPRT
SLDPRT/sprale_centrale.SLDPRT
Solidworks/spirale_centrale.SLDPRT
Solidworks/AX-12A/SetScrew.SLDPRT
Solidworks/CHARIOT.SLDPRT
Solidworks/MAKERBEAM/SQUARE_HEADED_BOLT_6mm.stp
Solidworks/MX-106.SLDASM
Solidworks/bague_ecrou_officiel/8854789.SLDPRT
Solidworks/spirob2/DOIGT.STL
