Raph1821/SpiRobs/LaTeX/Figures/construction_sketch.png

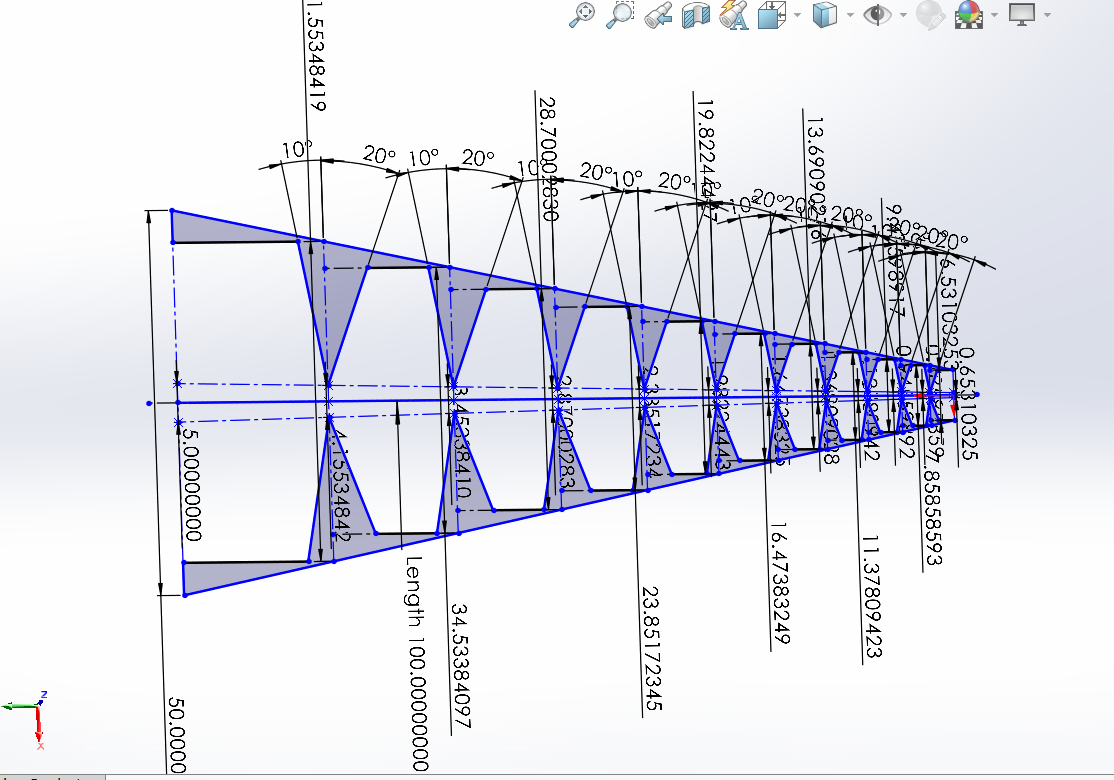
LaTeX/Figures/construction_sketch.png
