Raph1821/SpiRobs/Solidworks/PINCE_SIMULATION-Statique 1/PerformanceLog.txt

Number of Contacts: 12
Number of contact data: 1795
