Raph1821/SpiRobs/(commit log)

2025-06-06 add LaTeX
    [doigt.SLDPRT]
2025-06-06 calculation for SolidWorks
    [doigt.SLDPRT]
2025-06-09 add reference tendon
2025-06-12 add dessin écrou
    [AX-12A-01.SLDPRT, AX-12A-02.SLDPRT, AX-12A-03.SLDPRT, AX-12A-04.SLDPRT, AX-12A.SLDASM, ECROU.SLDPRT, SetScrew.SLDPRT, doigt.SLDPRT]
2025-06-12 add actionneur solidworks
    [Assemblage1.SLDASM, ECROU.SLDPRT, VIS MERE.SLDPRT]
2025-06-12 add glissière
    [Assemblage1.SLDASM, ECROU.SLDPRT, LINK.SLDPRT, RAIL.SLDPRT]
2025-06-13 Add Parameters'calcul, Spiral Sketch & 3D robotic arm model
    [epaisseur_trapeze.csv, largeur_trapeze.csv, spiral_flat.SLDPRT, spiral_flat.csv, spirale_centrale.SLDPRT, spirale_centrale.csv, spirale_originale.csv]
2025-06-13 add base
    [ACTIONNEUR.SLDASM, Assemblage1.SLDASM, BASE.SLDPRT]
2025-06-14 Finger's Update
    [epaisseur_trapeze.csv, largeur_trapeze.csv, spiral_flat.csv, spiral_flat_theta0_30_10_pieces.SLDPRT, spirale_centrale.csv, spirale_centrale_theta0_30_10_pieces.SLDPRT, spirale_originale.csv, trapeze_coords.csv]
2025-06-16 fingers's update 2
    [DOIGT.SLDPRT, spiral_flat.SLDPRT, spiral_flat_theta0_30_10_pieces.SLDPRT, spirale_centrale.SLDPRT]
2025-06-16 save SolidWorks assemblage
    [8854789.SLDPRT, ACTIONNEUR.SLDASM, BASE.SLDPRT, CHARIOT.SLDPRT, DOIGT.SLDPRT, GLISSIERE.SLDPRT, PINCE.SLDASM, RAIL.SLDPRT]
2025-06-16 continuing assemblage
    [BASE.SLDPRT, PINCE.SLDASM]
2025-06-16 Paremeters Update
    [epaisseur_trapeze.csv, largeur_trapeze.csv]
2025-06-16 DOIGT Update
    [DOIGT.SLDPRT]
2025-06-17 assemblage update
    [BASE.SLDPRT, LINK.SLDPRT, PINCE.SLDASM]
2025-06-17 add simulation
    [AX-12A-01.SLDPRT, AX-12A-02.SLDPRT, AX-12A-03.SLDPRT, AX-12A-04.SLDPRT, AX-12A.SLDASM, BASE.SLDPRT, CHARIOT.SLDPRT, DOIGT.SLDPRT]
2025-06-19 add MAKERBEAM
    [45_DEGREE.stp, 60_DEGREE.stp, BARRE_100.stp, BARRE_150.stp, BARRE_300.stp, CORNER.stp, CUBE.stp, POMME.SLDPRT]
2025-06-19 update base + pince + LaTeX
    [BASE.SLDPRT, DOIGT.SLDPRT, PINCE.SLDASM]
2025-06-19 update base + support_moteur
    [BARRE_40.stp, BARRE_60.stp, BASE.SLDPRT, MX-106.STEP, PINCE.SLDASM, SUPPORT.SLDASM]
2025-06-19 3rd update of Latex's 3rd part
    [spiral_flat_sketch.SLDPRT, spirale_centrale.SLDPRT, spirale_centrale_theta0_30_10_pieces.SLDPRT, sprale_centrale.SLDPRT]
2025-06-19 update LaTeX
    [ATTACHE.SLDPRT, ECROU.SLDPRT]
2025-06-19 Support for screw
    [FULL_SUPPORT_VIS.SLDASM, SUPPORT.SLDASM, Support_de_vis.SLDPRT, VIS MERE.SLDPRT]
2025-06-20 add BARRE_200
    [BARRE_200.stp]
2025-06-20 Still updating
    [spiral_flat_2.SLDPRT]
2025-06-20 update pieces
    [ATTACHE.SLDPRT, FULL_SUPPORT_VIS.SLDASM, SUPPORT.SLDASM, Support_de_vis.SLDPRT, VIS MERE.SLDPRT]
2025-06-20 update support. TODO: accrocher la glissière
    [CHARIOT.SLDPRT, CHARIOT.stp, PINCE.SLDASM, POMME.SLDPRT, SUPPORT.SLDASM, SUPPORT_DE_VIS_MOTEUR.SLDPRT, Support_de_vis.SLDPRT]
2025-06-20 New update
    [DOIGT.SLDPRT, FULL_SUPPORT_VIS.SLDASM, PINCE.SLDASM, Support_de_vis.SLDPRT]
2025-06-20 add écrou
    [ACCROCHE_GLISSIERE.SLDPRT, PINCE.SLDASM, SUPPORT.SLDASM]
2025-06-20 Rebuild pieces & Create servo support
    [CHARIOT.SLDPRT, MX-106.SLDASM, PINCE.SLDASM, SUPPORT.SLDASM, SUPPORT_DE_MOTEUR.SLDPRT, SUPPORT_DE_VIS_MOTEUR.SLDPRT]
2025-06-21 update assemblage
    [LINK.SLDPRT, PINCE.SLDASM, SUPPORT.SLDASM, SUPPORT_DE_MOTEUR.SLDPRT, SUPPORT_DE_VIS_MOTEUR.SLDPRT]
2025-06-25 add simulation + LaTeX
    [BASE.SLDPRT, DOIGT.SLDPRT, PINCE.SLDASM, POMME.SLDPRT, SIMULATION.SLDASM]
2025-06-25 Conflict Resolution
    [BASE.SLDPRT, DOIGT.SLDPRT, PINCE.SLDASM, POMME.SLDPRT, SIMULATION.SLDASM]
2025-06-26 ajout jeu
    [LINK.SLDPRT, PINCE.SLDASM, SUPPORT.SLDASM, SUPPORT_DE_MOTEUR.SLDPRT]
2025-06-26 add spirale enroulee
    [Symétrie19.SLDPRT, Symétrie20.SLDPRT, Symétrie21.SLDPRT, Symétrie22.SLDPRT, Symétrie23.SLDPRT, Symétrie24.SLDPRT, Symétrie25.SLDPRT, Symétrie26.SLDPRT]
2025-06-26 add assemblage doigt
    [Assemblage DOIGT.SLDASM, BASE.SLDPRT, PINCE.SLDASM, SUPPORT.SLDASM, Symétrie19.SLDPRT, Symétrie20.SLDPRT, Symétrie21.SLDPRT, Symétrie22.SLDPRT]
2025-06-27 add nouveau doigt assemblage
    [Assemblage DOIGT.SLDASM, BASE.SLDPRT, DOIGT.SLDPRT, LINK.SLDPRT, PINCE.SLDASM, PINCE_SIMULATION.SLDASM, POMME.SLDPRT, SUPPORT.SLDASM]
2025-06-27 résolution pb assemblage
    [PINCE.SLDASM, PINCE_SIMULATION.SLDASM, POMME.SLDPRT]
2025-06-27 suppression DOIGT
    [DOIGT.SLDPRT]
2025-06-27 nouveau doigt in progress
    [PINCE.SLDASM, PINCE_SIMULATION.SLDASM, POMME.SLDPRT, Symétrie1.SLDPRT, Symétrie10.SLDPRT, Symétrie11.SLDPRT, Symétrie12.SLDPRT, Symétrie2.SLDPRT]
2025-06-28 in progress...
    [Symétrie1.SLDPRT, Symétrie10.SLDPRT, Symétrie11.SLDPRT, Symétrie12.SLDPRT, Symétrie2.SLDPRT, Symétrie3.SLDPRT, Symétrie4.SLDPRT, Symétrie5.SLDPRT]
2025-06-28 doigt achevé, assemblage, tout ok + starting rapport
    [Assemblage DOIGT.SLDASM, BASE.SLDPRT, DOIGT.SLDPRT, PINCE.SLDASM, PINCE_SIMULATION.SLDASM, POMME.SLDPRT, SUPPORT.SLDASM, Symétrie1.SLDPRT]
2025-07-01 20 pages !
    [PINCE_SIMULATION.SLDASM]
2025-07-01 add motor control speed
2025-07-03 add conclusion
    [PINCE.SLDASM]
2025-07-05 add code moteur
    [ATTACHE.SLDPRT, LINK.SLDPRT, PINCE.SLDASM, SUPPORT.SLDASM]
2025-07-07 update poster
    [ATTACHE.SLDPRT, PINCE.SLDASM, SUPPORT.SLDASM]
2025-07-07 update assemblage + LaTeX + Poster
    [ATTACHE.SLDPRT, PINCE.SLDASM, SUPPORT.SLDASM]
